JaiPipatt/Capstone-Project/progress_reports/progress_report_1/progress_report.pdf

# Capstone Project Progress Report

### October 18, 2026

## 1 Project Timeline

- Completed:
- In progress:
- Next:

## 2 Project Phases

### 2.1 Phase A

### 2.2 Phase B

### 2.3 Phase C

### 2.4 Phase D

## 3 Module CAD Design


Figure 1: Exploded view of the module CAD design.


Figure 2: Front view of the module CAD design.


Figure 3: Rear view of the module CAD design.


Figure 4: Top view of the module CAD design.


Figure 5: Tilted sectional view of the module CAD design.

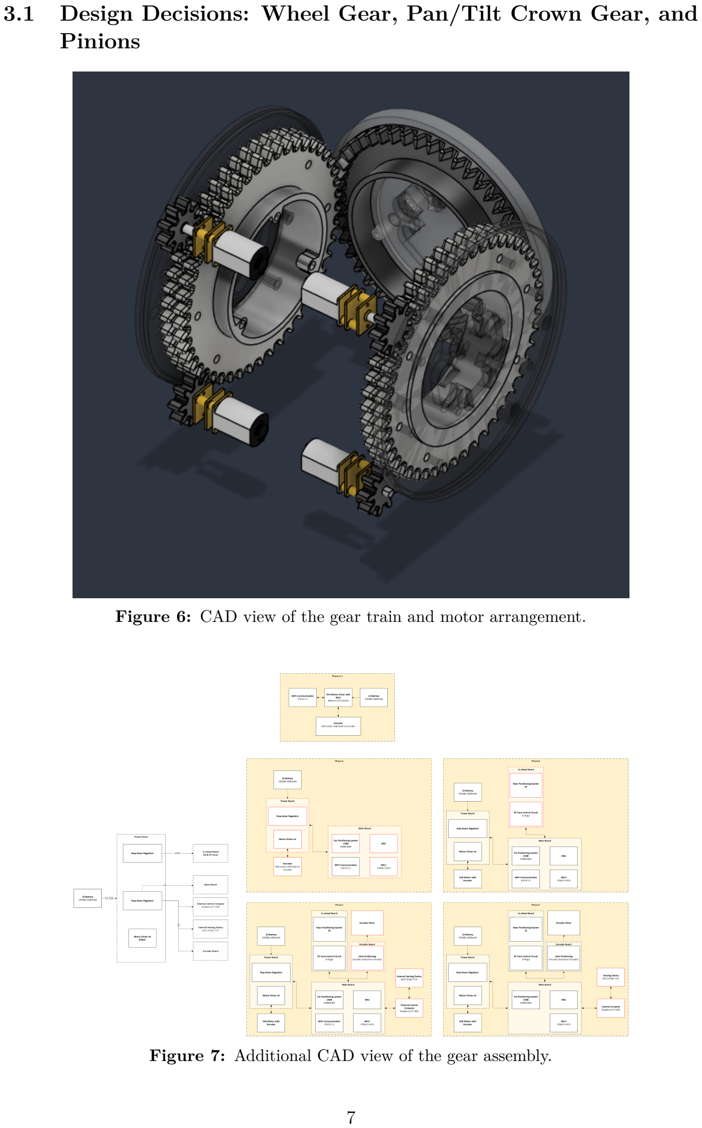
[picture p21: page 7]

### 3.1 Design Decisions: Wheel Gear, Pan/Tilt Crown Gear, and Pinions

Figure 6: CAD view of the gear train and motor arrangement.

Figure 7: Additional CAD view of the gear assembly.

### 3.1.1 Starting Point: Reverse-Engineering the SMORES-EP Reference

SMORES-EP is not open-source, so no CAD or drawing set was available. The gear train therefore had to be reconstructed from published dimensions and photographs and then re-derived from first principles.

The known reference parameters are listed in Table 1.

Table 1: Reconstructed SMORES-EP reference parameters.

Parameter | SMORES-EP

Module envelope 80 × 80 × 80 mm

Spur gear | 48 teeth
Crown gear | Same part as the spur gear, used at 90◦
Pinion | 9 teeth
Gearbox | 298:1

Assuming the 80 mm cube is the full envelope (wheels included), the largest gear that can physically fit is approximately 70 mm in outside diameter. Using the outside-diameter relation
Do = m(z + 2), | (1)

m =

70
48 + 2
= 1.4. | (2)

This gives a consistent, self-checking picture of the original: module 1.4, pitch diameter 67.2 mm, and a stage ratio of 48/9 = 5.33. This reconstructed module is the baseline against which all scaling decisions below are made.

### 3.1.2 Envelope Change and Its Consequences

The new module is 100 × 100 × 100 mm rather than 80 mm. This was driven by internal packaging (motors, gearboxes, electronics, and the pan/tilt joint) rather than by the gears themselves, but it directly sets the available gear space.

Allowing for wall thickness, bearing seats, and clearance to the housing, the largest practical spur gear outside diameter is 90 mm. Everything downstream follows from that number.

### 3.1.3 Wheel Spur Gear and Pinion

Tooth counts — why the ratio was held constant. The decision made first, before any dimension was fixed, was to preserve the original 5.33:1 stage ratio:

- Spur gear: 64 teeth
- Pinion: 12 teeth
- Ratio: 64/12 = 5.33 — identical to 48/9

The ratio was prioritised over any other parameter for three reasons:

1. The gearbox selection stays valid. The 298:1 gearbox reduction combines with the external stage to give the same total reduction as the reference design. Output speed and stall torque at the wheel therefore remain comparable, so motor and gearbox sizing carried over from SMORES-EP remains a defensible starting point instead of an unverified guess.
2. Published SMORES-EP performance data remains a usable benchmark. Locomotion speed, climbing ability, and joint torque figures reported for the original can be treated as an approximate expectation for this design. If the ratio had been changed, every performance claim would have had to be re-derived from scratch with no reference to check against.
3. Control and firmware behaviour is preserved. Encoder counts per wheel revolution, velocity limits, and any feed-forward torque terms scale with the total reduction. Holding it constant removes a whole class of retuning work.

Why 64/12 rather than 48/9 scaled directly. Multiple tooth-count pairs give 5.33:1. The pair 64/12 was chosen because increasing the pinion from 9 to 12 teeth materially improves the pinion, which is always the weakest and most heavily loaded element in the stage:

- Reduced undercutting. At a 20◦ pressure angle the theoretical minimum tooth count before undercut is zmin = 2/ sin² 20◦ ≈ 17. A 9-tooth pinion is far below this and suffers severe undercut at the tooth root, removing material exactly where bending stress is highest. A 12-tooth pinion is still below the theoretical limit, but the root section is considerably healthier.
- Higher contact ratio. More teeth on the pinion increases the length of the line of action relative to the base pitch, so more teeth share the load at any instant. This reduces peak tooth stress and smooths torque transmission.
- Better load sharing per cycle. A 12-tooth pinion completes fewer revolutions per gear revolution than a 9-tooth pinion, so each pinion tooth accumulates fewer loading cycles over the robot’s life — a direct fatigue-life benefit for the most stressed part.
- Larger pinion bore. A 12-tooth pinion at this module has enough body to carry the motor shaft bore and the wall thickness around it without the bore breaking into the tooth roots.

Undercut outcome at 12 teeth. Because 12 teeth sits below the 17-tooth theoretical threshold, some root undercut is expected in the generated profile. On inspection of the generated geometry and on assembling the mesh in CAD, the undercut present at 12 teeth does not cause interference: the mating spur gear tooth tips clear the undercut region throughout the mesh cycle at the design centre distance, and no tip-to-root fouling is observed. The undercut is therefore accepted as a minor reduction in root section rather than treated as a defect requiring correction, and no profile shift was applied. This keeps the pinion a standard, directly generated part.

Resulting geometry. With 64 teeth at a 90 mm outside diameter,

m =

90
64 + 2
= 1.3636 ≈ 1.36. | (3)

The resulting geometry is summarised in Table 2.

Table 2: Wheel spur gear and pinion geometry.

Parameter | Value
Module, m | 1.36
Pressure angle | 20◦ (standard)
Spur gear teeth | 64
Spur pitch diameter | 87.04 mm
Spur outside diameter | 90 mm
Pinion teeth | 12
Pinion pitch diameter | 16.32 mm
Pinion outside diameter | 19.04 mm

Theoretical centre distance 51.68 mm

Face width | 5 mm
Backlash | 0.2 mm
Root fillet | 0.3 mm

A 20◦ pressure angle was used throughout. It is the industry standard, it gives thicker tooth roots and better load capacity than 14.5

◦
| , it tolerates small centre-distance er-
rors well (important for a printed or lightly-toleranced housing), and it is the default assumption of every standard gear generator and cutting tool, which keeps the design manufacturable by more than one process.

The gears were generated using the Fusion 360 spur gear extension, entering pressure angle, module, tooth count, backlash, root fillet, and face width directly. Using a parametric generator rather than hand-sketched profiles guarantees a true involute flank and makes it cheap to regenerate the part when an upstream parameter changes — which, as the following subsection shows, happened repeatedly.

The 0.2 mm backlash and 0.3 mm root fillet are deliberate manufacturing allowances rather than theoretical values. Backlash absorbs centre-distance error, shaft deflection, bearing play, and thermal expansion, preventing tooth binding; the root fillet reduces the stress concentration at the tooth root, which is the standard bending-failure location.

### 3.1.4 Pan/Tilt Crown Gear

Departure from the SMORES-EP approach. SMORES-EP used a single gear part in two roles: as a conventional spur gear, and as a de facto crown gear meshing at 90◦
. This is convenient for manufacturing — one part number, one tool — but it is a compromise. A spur profile engaged at 90◦ does not have conjugate contact with its mate; contact degenerates toward a point or a short line near the tooth tip, which concentrates stress, increases wear, and produces a mesh that is sensitive to axial position.

This design instead uses a true crown (face) gear, with teeth formed on the face of the disc and oriented vertically so that they mesh with the mating spur gear. This gives line contact across the tooth face and a substantially better load distribution for the same envelope.

Iteration history. The crown gear was the most constrained part in the assembly, because its diameter had to coexist with the motors, the gearboxes, the two wheel gear trains, and the structural frame — all inside the 100 mm cube. The iterations are given in Table 3.

Table 3: Crown gear sizing iterations.

Iteration Diameter Teeth / Module Outcome

1 | 90 mm | 48 / 1.8 | Interference with surround- ing assembly — rejected
Final | 84 mm | 46 / 1.75 | Fits with clearance

The first attempt simply mirrored the spur gear’s 90 mm diameter. On assembly it fouled adjacent components, so the diameter had to be reduced. The final geometry is consistent with the same outside-diameter relation:

Do = 1.75 × (46 + 2) = 84 mm. | (4)

Module mismatch: an accepted, envelope-driven compromise. Standard gear practice requires that two meshing gears share the same module and the same pressure angle, since the module fixes the circular pitch and therefore whether the teeth index correctly against one another. That condition could not be satisfied here. Two constraints fixed the geometry before the module could be chosen freely:

1. Both diameters are fixed by packaging. The spur gear outside diameter is capped at 90 mm by the 100 mm envelope, and the crown gear outside diameter is capped at 84 mm by interference with the motors, gearboxes, and frame — as established in the iteration above. Neither diameter is a free variable.
2. The tooth counts are fixed by the ratios being preserved. The spur gear must have 64 teeth to hold the 5.33:1 wheel stage ratio, and the crown gear must stay near 46–48 teeth to hold the near-1:1 spur-to-crown relationship of the original design.

With both Do and z fixed on each part, m = Do/(z + 2) is fully determined, and the two values simply are not equal: 1.36 for the spur gear against 1.75 for the crown gear. Forcing a common module would have required either abandoning the preserved gear ratios — discarding the benchmark value of the SMORES-EP reference data and the validity of the motor and gearbox selection — or enlarging a gear beyond the envelope it has to fit in.

The design therefore treats matched modules as the parameter to sacrifice, because it is the one whose relaxation is recoverable at assembly (through tooth-depth and backlash adjustment) rather than structural. Concretely, the crown tooth depth was tuned during iteration to obtain a working mesh at the assembled centre distance, and the dedendum modification described below is part of that adjustment. This is a documented deviation from standard practice rather than an oversight, and it is one of the primary items to be validated once physical parts exist.

Why tooth count was held near 1:1 with the spur gear. The original design has an effective 1:1 tooth-count relationship between spur and crown (48 and 48). Rather than abandoning this when the diameter had to shrink, the design keeps the counts as close as the envelope permits: 46 teeth against the original’s 48, a 4 % deviation.

Keeping the tooth counts nearly equal, and therefore the tooth size nearly equal, matters for several reasons:

- The pan/tilt joint ratio stays near unity. With a near-1:1 mesh, output speed and torque at the joint are close to what the driving stage delivers. The joint’s angular velocity and holding torque are therefore predictable from the motor and gearbox specification without an extra reduction factor to characterise, and the SMORES-EP joint performance data stays usable as a benchmark.
- Tooth size — not just ratio — sets load capacity. Tooth bending strength scales roughly with the square of the module for a given face width and material (Lewis bending equation). A 46-tooth crown at m = 1.75 has larger teeth than the 64-tooth spur at m = 1.36, so the crown teeth are individually stronger. This is desirable: the crown gear carries the full pan/tilt reaction load, including any static holding torque when the joint is supporting the robot’s own weight or resisting an external load, and it is the harder part to replace.
- Mesh symmetry between the two driving gears. Because two identical spur gears drive the single crown from opposite sides, keeping the crown’s tooth size and count close to symmetric ensures both meshes see comparable loading and wear, rather than one side dominating.
- No hidden speed asymmetry between pan and tilt. Pan and tilt are produced by the same two inputs in common mode or differential mode. A near-1:1 crown keeps the effective ratio for both modes similar, so the two motions have comparable speed and torque characteristics and can share a single control tuning.

Dedendum modification. Standard practice sets the dedendum to 1.25 m, which for m = 1.75 gives 2.1875 mm. The design uses a slightly reduced 2.15 mm.

This small reduction (0.0375 mm, about 1.7 %) trims the root depth just enough to clear the mating tooth tip within the assembled centre distance without carving further into the root section. Because tooth bending strength is governed by the root thickness, a shallower dedendum marginally increases the root section and therefore does not weaken the tooth — the trade-off is a small reduction in tip clearance, which is acceptable given the 0.2 mm backlash already designed in. It is a compromise between manufacturing feasibility and the clearance required to avoid tip-to-root interference.

### 3.1.5 Pinion Mounting and Tolerances

The two pinion variants differ only in how they attach to the motor shaft, which is dictated by their position in the assembly (Table 4).

A 0.1 mm tolerance is applied to the shaft bores. This is a clearance/transition allowance covering manufacturing variation in both the printed or machined bore and the shaft

Table 4: Pinion bore variants.

Pinion | Bore | Rationale

Pan/tilt Through-hole The motor shaft passes fully
| | through the pinion, allowing the shaft to be supported on both sides and the pinion to sit at an arbi- trary axial position along it
Wheel | Blind hole | Fitted onto the end of the shaft; the closed face provides a positive axial stop and a sealed, stiffer end

diameter. Too tight and the pinion cracks or cannot be assembled; too loose and backlash appears at the shaft interface, degrading positional accuracy and introducing shock loading on direction reversal.

The gears and plain-bearing surfaces will be printed in nylon. Nylon was selected because it provides good strength for the expected mechanical loads while also offering relatively low friction and wear, which is useful for the plain-bearing interfaces in the module. The final shaft-to-bore fit is not yet treated as fixed: a test shaft and bore will be printed first, measured, and assembled to determine whether the nominal 0.1 mm allowance provides the required balance between free movement and acceptable backlash. The bore dimension will be adjusted if the first test shows that the printed nylon shrinks, distorts, or grips the shaft more than expected.

The spur gear carries a bolt-hole pattern on its web for attachment to the wheel hub and to adjacent structural parts. Placing the holes in the web rather than near the rim keeps them clear of the tooth root region, where bending stress is highest.

### 3.1.6 Drivetrain Architecture

The module uses four motors driving four spur gears:

- Outer two spur gears — one per side, each driving a wheel directly. These provide differential-drive locomotion.
- Inner two spur gears — both mesh with the single crown gear that carries the two side-mounted spur gears.

The pan/tilt degrees of freedom are produced differentially from these two inner inputs:

- Inner gears rotating in the same direction (common mode) → pan
- Inner gears rotating in opposite directions (differential mode) → tilt

This differential arrangement is the main structural reason the crown gear geometry matters so much. Both inner spur gears must mesh with the same crown gear simultaneously and symmetrically; any asymmetry in the two meshes appears as a coupling error between the pan and tilt axes, not merely as local wear. It also explains why crown gear diameter was the binding constraint during iteration — it must remain concentric with the joint axis while two separate drive trains and two wheel trains are packed around it.

### 3.1.7 Summary of Final Parameters

Table 5: Final gear train parameters.

Component | Teeth Module Outside dia. Notes
Wheel/drive spur gear 64 | 1.36 | 90 mm | 5 mm | face | width,
mounting holes in web
Pinion (both types) | 12 | 1.36 | 19.04 mm | Through-bore
(pan/tilt) or | blind
bore (wheel)
Crown gear | 46 | 1.75 | 84 mm | Dedendum 2.15 mm;
true face-gear teeth

Common to all: 20◦ pressure angle, 0.2 mm backlash, 0.3 mm root fillet, 0.1 mm bore tolerance.

### 3.1.8 Current Status and Remaining Work

All of the geometry above exists as a CAD model only. No part of the gear train has been 3D printed, manufactured, or tested in the real world at the time of writing. Every clearance, interference, and mesh result reported in this section was obtained from the CAD assembly, not from physical hardware, and should be read as a design intent rather than a verified outcome.

The following items are therefore outstanding and are the priority for the next phase:

- Print a first article of the spur gear, both pinions, and the crown gear, and verify that the spur/crown mesh functions despite the module mismatch discussed above.
- Confirm that the 12-tooth pinion’s undercut remains non-interfering at real printed tolerances, where layer resolution and shrinkage are additional error sources not captured in CAD.
- Check that the 0.2 mm backlash and 0.1 mm bore tolerance are appropriate for the chosen printing process and material; adjust and reprint if the fit is tight or loose.
- Measure the achieved pan and tilt ranges and the joint holding torque against the SMORES-EP benchmark figures used to justify the ratio decisions.
- Run an endurance check on the crown gear teeth, which carry the highest sustained load in the assembly.

The outer mechanical design is based on the SMORES-EP modular robot developed by the ModLab at the University of Pennsylvania [?]. The original SMORES-EP module is approximately 80 mm in size. For our prototype, the main dimensions were adapted to 100 mm to provide more space for the required mechanical and electronic components.

### 3.2 Outer Wheels

Two independently driven outer wheels were designed based on the differential-drive arrangement of SMORES-EP. Each wheel has a diameter of 100 mm and includes a groove for an NBR N70 O-ring with a cross-section of approximately 1.5 mm, which is used as the rubber tire. Space for the EP-magnet docking mechanism is also provided in the wheel. Mounting posts were added to provide a mounting location for the PCB that will generate the electrical pulse for switching the EP-magnet coil.


Figure 8: Interior view of the wheel and drivetrain assembly.


Figure 9: Exterior view of the wheel and module assembly.

### 3.3 Pan Face

The pan face was designed based on the SMORES-EP pan mechanism. It has a diameter of 90 mm and does not include the O-ring groove used on the driving wheels. Space for the EP-magnet docking mechanism is included in the face.

### 3.4 Tilt Face

The tilt face was adapted from the SMORES-EP tilt mechanism. The outer rectangular part has dimensions of approximately 90×71.6 mm and includes space for the EP-magnet docking mechanism. An additional motor mount was added to accommodate the motor used in our prototype.

## 4 Electronics: Project Plan and Current State

### 4.1 Electronics work plan

The electronics work follows the four project phases, split into A-1, A, B, C and D. Each phase’s block diagram shows the subsystems built in that phase; dashed boxes mark the module or PDB that holds them.

Phase A-1 uses COTS parts for early locomotion and mechanism testing: a 2S battery, a 4-channel motor driver with built-in MCU, and an ESP32-C3 for Wi-Fi (Figure 10).

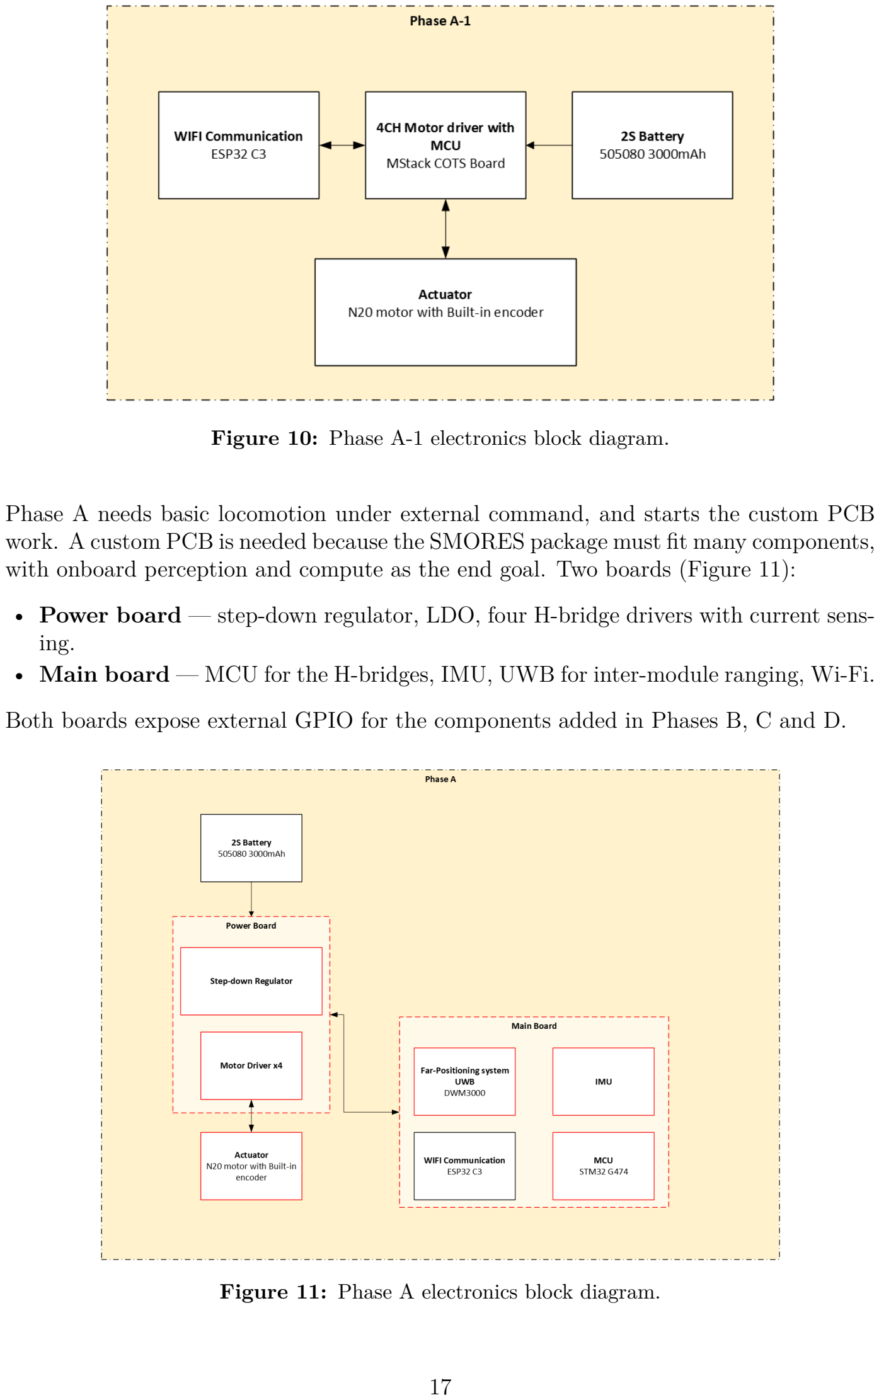
[picture p22: page 17]

Figure 10: Phase A-1 electronics block diagram.

Phase A needs basic locomotion under external command, and starts the custom PCB work. A custom PCB is needed because the SMORES package must fit many components, with onboard perception and compute as the end goal. Two boards (Figure 11):

- Power board — step-down regulator, LDO, four H-bridge drivers with current sensing.
- Main board — MCU for the H-bridges, IMU, UWB for inter-module ranging, Wi-Fi.

Both boards expose external GPIO for the components added in Phases B, C and D.

Figure 11: Phase A electronics block diagram.

Phase B needs module-to-module connection. The work is an in-wheel PCB with the EP-Face circuitry and the IR contact-alignment circuit. It is powered from the power board and talks to the main board through a slip ring, covered in the electrical connection section (Figure 12).


Figure 12: Phase B electronics block diagram.

Phase C adds onboard perception: an RGB-D/ToF camera, with the compute unit still wired externally. It also adds a wheel encoder, because the motor’s built-in encoder sits before several gear stages and cannot sense wheel angle precisely (Figure 13).

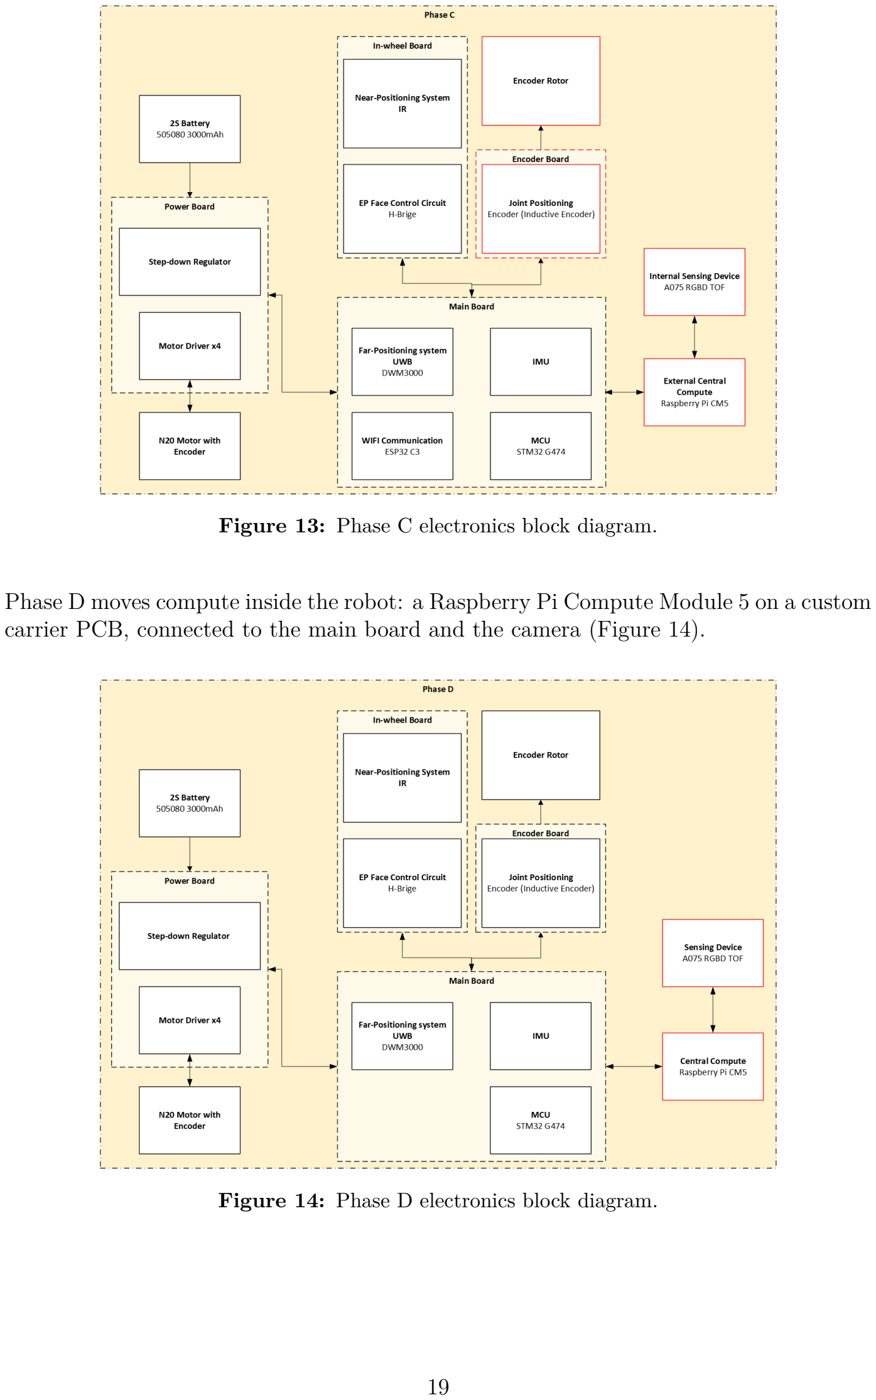
[picture p23: page 19]

Figure 13: Phase C electronics block diagram.

Phase D moves compute inside the robot: a Raspberry Pi Compute Module 5 on a custom carrier PCB, connected to the main board and the camera (Figure 14).

Figure 14: Phase D electronics block diagram.

### 4.2 Electronics component selection

Table 6 lists the selected components, their subsystem and the specifications behind the choice. Values are from datasheets; the EP-Face and IR board is custom and its figures come from the Phase B build.

Table 6: Selected electronics components by subsystem.

Component Subsystem and
phase
Key specifications | Interface and
supply

4 × N20
gearmotor
with encoder

Joint drive for the
four DoF (left,
right, pan, tilt);
Phase A-1 onward

6 V, 50 rpm; magnetic
quadrature encoder, 7 PPR, on the motor shaft

A/B quadrature
to the MCU;
driven by
H-bridge

STM32G474 Main-board MCU:
joint control, sensor
sampling, data link;
Phase A onward

Cortex-M4F at 170 MHz;
timer-triggered 12-bit ADCs; three FDCAN

SPI, I2C,
UART, CAN;
1.71–3.6 V

ICM-42688-P 6-axis IMU for attitude and
orientation; Phase
A onward

Gyro ±2000 dps, accel ±16 g; ODR to 32 kHz

SPI or I2C;
1.71–3.6 V

Qorvo
(Decawave)
DW3000

UWB transceiver
for inter-module
ranging and coarse
relative
localisation; Phase
A onward

IEEE 802.15.4z; channels 5 and 9; ranging accuracy of order 10 cm

SPI; 2.4–3.6 V

ESP32-C3 | Wi-Fi link; standalone controller in Phase A-1, wireless co-processor from Phase A
RISC-V at 160 MHz; Wi-Fi 4 and Bluetooth 5 LE

UART or SPI to
the main MCU;
3.0–3.6 V

EP-Face and
IR board

In-wheel docking
face:
electropermanent
magnet connector
and IR
contact-alignment
sensing; Phase B

Custom PCB; EP magnet
pulse-switched, holds with no power; IR emitter/receiver pairs. Figures set by the Phase B design

Powered from
the power board;
data via slip ring

Raspberry Pi
Compute
Module 5

Onboard compute
for perception and
planning; Phase D

Quad-core Cortex-A76 at
2.4 GHz; 2–16 GB RAM; PCIe and MIPI CSI

Custom carrier
board; 5 V

Sipeed
MaixSense
A075V

RGB-D/ToF
camera for onboard
perception; Phase
C onward

ToF depth 320 × 240 at 30 fps, range 0.2–2 m; RGB 800 × 600

USB 2.0 or
UART; 5 V

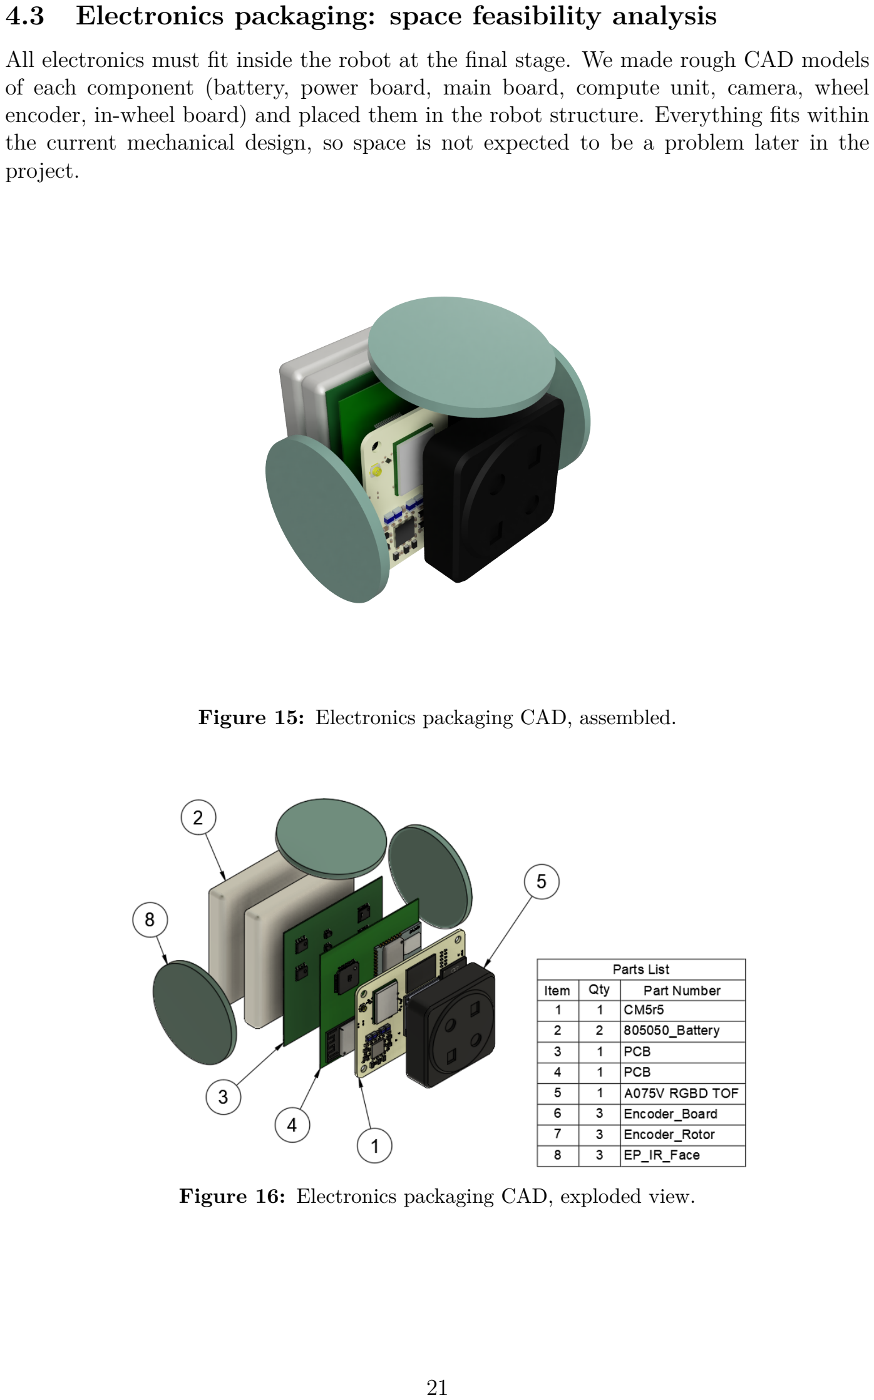
[picture p24: page 21]

### 4.3 Electronics packaging: space feasibility analysis

All electronics must fit inside the robot at the final stage. We made rough CAD models of each component (battery, power board, main board, compute unit, camera, wheel encoder, in-wheel board) and placed them in the robot structure. Everything fits within the current mechanical design, so space is not expected to be a problem later in the project.

Figure 15: Electronics packaging CAD, assembled.

Figure 16: Electronics packaging CAD, exploded view.

### 4.4 Additional scope not covered in the proposal: wheel encoder

The original SMORES sensed joint angle with a continuous-rotation potentiometer geared to the joint shaft. The wiper voltage gives the shaft angle directly, so position is absolute at power-up with no homing. The cost is coarse resolution (about 5◦
), contact wear, and
backlash from the gear stage. The project is replacing this with a non-contact encoder.

Three options were considered; Table 7 compares them.

Table 7: Wheel-rotation sensing options compared.

Criterion | On-axis magnetic rotary encoder (e.g. AS5600, AS5048) | Off-axis magnetic tape encoder (1 mm pole pitch)
Custom inductive
encoder (PCB coil
and
inductance-to-digital
IC)
Sensing principle | Diametrically magnetised magnet on the shaft end, read by a Hall-effect IC; angle from atan2(sin, cos) | Magnetised tape ring bonded to the wheel rim, read off-axis by a magnetoresistive or Hall read head at a fixed radial gap

PCB transmit and
receive coils excite eddy
currents in a conductive
rotor target; phase and
amplitude of the return
signal encode angle
Output | Absolute over one turn | Incremental; an index or reference mark is needed to recover absolute position

Absolute over one turn,
depending on coil layout
Resolution | 12–14 bit; below 0.1◦
| with interpolation

Set by pole pitch and
interpolation; medium
to high

Set by coil geometry;
comparable to magnetic
encoders with
interpolation
Mounting | Requires a free shaft end centred on the sensor IC

Anywhere on the rim;
the shaft end stays free

Flat PCB facing the
rotor target with a
controlled
sub-millimetre air gap
Immunity to magnetic fields | Sensitive to stray fields from the motors and the EP connector; needs shielding or standoff distance
Same exposure as
on-axis, plus sensitivity
to tape bonding and
alignment error

Immune; unaffected by
the motors or the EP
connector

Design effort
and cost

Low; off-the-shelf IC
with mature firmware

Medium; tape must be
applied and aligned
precisely, and a
dedicated read-head IC
is needed

High; custom coil
design, rotor target
machining and
calibration, with no
drop-in part

Fit for this
project

Simplest and lowest
risk, but the SMORES
layout already uses the
wheel shaft end for
gearing and mounting,
so a clear axial spot
must be reserved

Frees the shaft end, but
adds a homing step at
power-up and a wear
and bonding risk on the
tape

Best fit to the EP
connector’s nearby field,
but the highest design
time and schedule risk
within the capstone
timeline

The EP connector’s field is close to the wheel sensor, so the two magnetic options carry an interference risk the inductive option does not. Weighing that against the extra design effort is the open decision for Phase C.

### 4.5 Current focus: robot locomotion

### 4.5.1 Power system

The budget is built in three steps: the current each component draws (Table 8), the average load over a mission once duty cycles are applied (Table 9), and the power drawn from the pack after regulator losses, which gives the run time (Table 10).

Component loads. Table 8 gives the rail, typical current and maximum current for each component. Typical is normal duty; maximum is the worst case the power IC must survive. Rows marked * are estimates to be measured in Phase A-1.

Table 8: Component current by rail.

Component | Rail | Typical current

Maximum
current

Condition

4 × N20
gearmotor (6 V,
50 rpm)

Pack,
PWMlimited to
6 V

0.07 A each;
0.28 A for
four

1.0 A each;
4.0 A for
four

Typical is no-load;
maximum is all four stalled, at 6 V equivalent
STM32G474 | 3.3 V | 30 mA | 60 mA | 170 MHz; maximum with all peripherals active
ICM-42688-P | 1.8 V (3.3 V
I/O)
| | 0.9 mA | 1.2 mA | Six-axis low-noise mode
DW3000* | 3.3 V | 45 mA | 50 mA | Listening; transmit peak. Idle about 10 mA, deep sleep below 1 µA
ESP32-C3 | 3.3 V | 90 mA | 335 mA | Wi-Fi active; maximum is 802.11b transmit. Modem sleep 20 mA
EP-Face and IR board* | — | — | To be calculated from the EP design | Steady draw is IR only; the EP magnet holds with no current. The pulse comes from a local capacitor, so the rail only sees recharge current

Raspberry Pi Compute Module

5 * | 5 V | 1.2 A | 3.0 A | Idle about 0.6 A; maximum is full CPU load, no USB peripherals
Sipeed MaixSense A075V* | 5 V | 0.4 A | 0.5 A | ToF illuminator active at 30 fps

Mission average. Table 9 applies a duty cycle to each component over a representative mission: mostly driving, intermittent ranging, occasional docking, perception always on.

Table 9: Estimated average load over a representative mission.

Component | Rail | Active current
Duty cycle | Average
current at
rail

Average
power

2 × N20 wheel
motors

Pack,
PWM to
6 V

0.25 A each
(loaded, est.)

60 %
(driving)
0.30 A | 1.80W

2 × N20 pan and
tilt motors

Pack,
PWM to
6 V

0.25 A each
(loaded, est.)

15 % (reconfiguring)

0.075 A | 0.45W
STM32G474 | 3.3 V | 30 mA | 100 % | 30 mA | 0.10W
ICM-42688-P | 1.8 V | 0.9 mA | 100 % | 0.9 mA | <0.01W
DW3000 | 3.3 V | 45 mA listening; 10 mA idle | 25 % ranging, 75 % idle | 19 mA | 0.06W
ESP32-C3 | 3.3 V | 90 mA active; 20 mA modem sleep

60 % active,
40 % sleep
62 mA | 0.20W

EP-Face and IR
board
3.3 V | 35 mA | 20 % docking approach
7 mA | 0.02W

Raspberry Pi
Compute Module
5
5 V | 1.2 A | 100 % | 1.2 A | 6.00W

Sipeed MaixSense
A075V
5 V | 0.4 A | 80 % | 0.32 A | 1.60W

Total at the
rails

10.2W

Table 10: Power drawn from the pack by rail, including converter efficiency.

Rail | Load at rail | Conversion from pack | Power from pack
Motors (pack, PWM to 6 V) 2.25W | H-bridge, 95 % | 2.4W
5 V (compute, camera) | 7.60W | Buck, 90 % | 8.4W
3.3 V and 1.8 V (MCU, sensors, radios) | 0.38W | LDO from 5 V, 66 %, then buck, 90 % | 0.65W
Total from pack | 11.5W

Battery run time. The pack is two 505080 cells in series, 3000 mAh, 22.2Wh, of which 17.8Wh is usable to cutoff. 11.5W from the pack is 1.55 A at 7.4 V, about 0.5 C. Run time is about 1.5 h for the full Phase D module; the Phase A and B configuration, without compute and camera (73 % of the draw), runs about 5.8 h.

### 4.5.2 Power board components


Figure 17: Power distribution block diagram.

Power splits into three paths from the 2S pack:

- Motors. The four N20s run from the pack through the H-bridges. PWM duty is capped at about 70 % (6 V over 8.4 V at full charge) to hold the motors at their 6 V rating, and the H-bridge current sensing trips on stall. The on-time current at stall scales to about 1.4 A, so the H-bridges are rated for the pack voltage and 1.5 A per channel.
- EP-Face and IR. A dedicated step-down regulator feeds the in-wheel board and its pulse capacitor. The pulse itself comes from the capacitor; the separate regulator keeps the recharge current and pulse transients off the logic rail so the MCU and compute unit do not brown out during docking.
- Logic and compute. A second step-down regulator provides 5 V to the main board, encoder circuit, compute unit and camera; 3.3 V for the MCU, sensors and radios comes from an LDO on the main board. This rail carries about 1.6 A typical and 4 A peak (Table 8), so the regulator is rated 5 V / 5 A, which also meets the Compute Module 5 supply requirement.

Table 11: Maximum load per rail.

Rail | Loads | Maximum current | Maximum power
Motor drive (pack, PWM to 6 V) | 4 × N20 | 4.0 A at 6 V equivalent; 1.4 A per channel on-time at 8.4 V | 24W

5 V logic and
compute

CM5 3.0 A, camera 0.5 A,
3.3 V LDO input 0.45 A
4.0 A | 20W
3.3 V (from 5 V) | STM32 60 mA, IMU 1 mA,
DW3000 50 mA, ESP32-C3
335 mA

0.45 A (ESP32 transmit
burst)

1.5W

EP-Face and IR | IR 50 mA, pulse capacitor recharge

0.05 A steady +
recharge, TBD

TBD

Pack total | all rails at peak | ≈6.5 A at 7.4 V, ≈7.3 A at 6.6 V

≈47W

## 5 Preparation for Phase B: Magnet

The magnetic docking system is based on the Electro-Permanent Magnet EPM connector developed for SMORES-EP [?]. The original SMORES-EP module has a characteristic length of approximately 80 mm, and its EP-Face uses four EP magnets arranged in a ring on the connecting face. Each EP magnet consists of an AlNiCo 5 cylindrical magnet and an NdFeB magnet placed side by side, two low-carbon steel pole pieces, and a copper coil wound around the magnetic assembly. The original EP-Face uses magnet cylinders 4.76 mm in diameter and 9.53 mm in length, with the four-magnet arrangement fitting within a 42 mm diameter circular region. The magnets protrude approximately 0.5 mm from the connecting face. The copper coil uses 30 AWG wire with 200 turns [?]. For our 100 mm prototype, this arrangement and its associated dimensions serve as the design reference and are being adapted to fit our larger face and mechanical structure.


Figure 18: Interior view of the rectangular magnet housing.

The operating principle relies on the contrasting magnetic properties of AlNiCo 5 and NdFeB. AlNiCo 5 has relatively low coercivity, meaning its magnetization direction can be reversed by an external magnetic field. NdFeB, in contrast, has high coercivity and retains its magnetization under the same field pulse. This difference allows the two magnets to work together as a switchable permanent-magnet system.

A short electrical pulse is sent through the copper coil, generating a magnetic field around the magnet assembly. This pulse reverses the magnetization direction of the AlNiCo 5 while the NdFeB remains magnetized in its original direction. When the two magnetic fields are aligned, they reinforce each other and the resulting magnetic flux is guided through the steel pole pieces toward the connecting face. This produces the ON state, generating an attractive force with a mating EP connector.

When a pulse is applied in the opposite direction, the AlNiCo 5 magnetization reverses while the NdFeB remains unchanged. The two magnetic fields then oppose each other, reducing the magnetic flux reaching the connecting face. This produces the OFF state, allowing the modules to separate. Since the magnetic state remains after the pulse, continuous power is not required to maintain the ON or OFF state.

The original EP-Face uses AlNiCo 5, NdFeB, ASTM 1018 low-carbon steel pole pieces, and a copper coil with 30 AWG wire and 200 turns. For our prototype, the selected materials are:

- AlNiCo 5 rod magnet
- NdFeB magnet
- Mild steel 1018 / S20C
- 30 AWG enamelled copper wire

The EP-magnet dimensions, coil winding parameters, and driving circuit will be finalized through fabrication and testing in Phase B.

## 6 Shaft Tolerance Analysis: Plain Bearing (∅55 mm)

The plain bearing (OD = 55 mm, ID = 50 mm) acts as the shaft. Every printed nylon component has a bore that fits around the bearing outer diameter. Four joints use this interface, classified in Table 12.

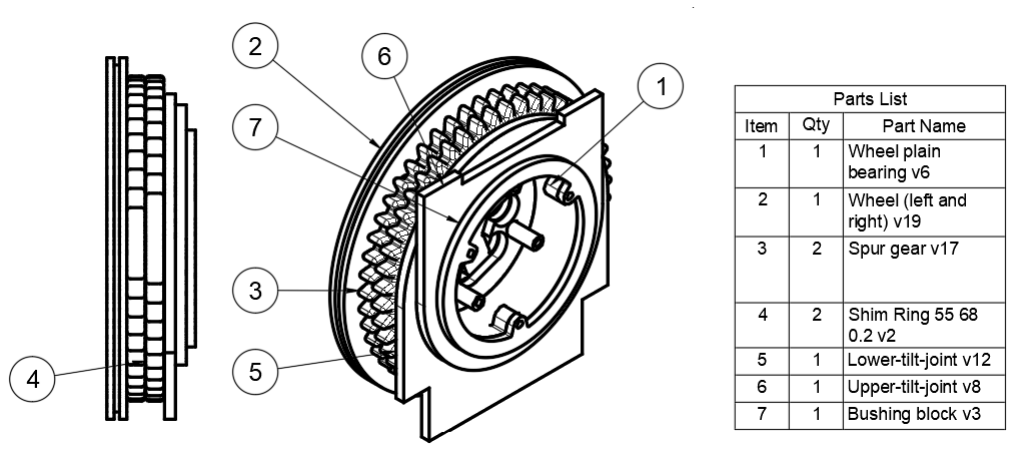
[picture p25: figure]

Figure 19: Shaft and bearing component arrangement.

Table 12: Joint classification for the ∅55 mm bearing interface.

Joint Component | Motion | Fit | ISO Class
J1 | Wheel + 1st Spur Gear | Dynamic Clearance | F7/h6
J2 | 2nd Spur Gear (Pan/Tilt) Dynamic Clearance | F7/h6
J3 | Upper Tilt Joint | Dynamic Clearance | F7/h6
J4 | Lower Tilt Joint | Static | Interference P7/h6

### 6.1 ISO 286 Tolerance Results

For ∅55 mm (size range 50 < d ≤ 80 mm), the tolerance unit is i = 1.856 µm, giving IT6 = 19 µm and IT7 = 30 µm. The bearing OD is modelled as h6 (55.000–54.981 mm). Table 13 summarises the theoretical fit limits.

Table 13: ISO 286 theoretical fit limits.

Type | Bore Class Dmin (mm) Dmax (mm) Fit Min (mm) Fit Max (mm)
Dynamic F7 | 55.030 | 55.060 | +0.030 CL | +0.079 CL
Static | P7 | 54.938 | 54.968 | +0.013 IF | +0.062 IF

### 6.2 3D-Printing Compensation

FDM-printed holes in nylon are systematically undersized (≈ −0.10 to −0.30 mm diametrally) due to inward filament flow, thermal contraction (1–2 %), and surface roughness. The CAD bore is therefore oversized to compensate: DCAD = Dtarget + |∆hole|. Dynamic bores receive +0.20 mm compensation; static bores receive +0.10 mm (smaller, because shrinkage helps create the desired interference).

### 6.3 Recommended Bore Sizes

Table 14 gives the recommended starting CAD bore for each part. These values will be validated through the print-and-test procedure described below.

Table 14: Recommended CAD bore sizes for ∅55 mm bearing.

Part | Joint | CAD Bore (mm) Expected Fit
Wheel (Item 2) | J1 Dynamic | ∅55.30 | ≈ 0.10–0.20 CL

1

st Spur Gear (Item 3) | J1 Dynamic | ∅55.30 | ≈ 0.10–0.20 CL

2

nd Spur Gear (Item 3) | J2 Dynamic | ∅55.30 | ≈ 0.10–0.20 CL
Upper Tilt Joint (Item 6) J3 Dynamic | ∅55.30 | ≈ 0.10–0.20 CL
Lower Tilt Joint (Item 5) J4 Static | ∅54.90 | ≈ 0.05–0.15 IF
CL = Clearance | IF = Interference | Bearing OD = ∅55.00 mm

### 6.4 Print-and-Test Procedure

Test rings (OD = 70 mm, height = 10 mm) will be printed in nylon at five CAD bore sizes for each fit type:

- Dynamic (J1–J3): ∅55.10, 55.20, 55.30 (recommended), 55.40, 55.50 mm. Pass criterion: bearing slides in by hand, part spins freely, radial play ≤ 0.20 mm.
- Static (J4): ∅54.70, 54.80, 54.90 (recommended), 55.00, 55.10 mm. Pass criterion: bearing requires firm hand pressure or light mallet tap to insert, no rotation under hand torque, no cracking.

Parts are cooled to room temperature (23(2) ◦C) for ≥ 2 hours before measurement. Each bore is measured with a digital caliper at three angles (0

| | ◦ , 60◦

, 120◦
| | | ) and averaged. The
printer offset is ∆ = Dmeasured − DCAD (typically −0.10 to −0.30 mm). The smallest dynamic bore that spins freely and the largest static bore that prevents rotation are selected for production prints.

## 7 Software Testing Plan for Phase A

This section describes the testing plan for evaluating the software system during Phase
A. The objective is to verify that the software system can reliably detect and identify the robot ID from AprilTags using an external camera and image processing techniques. The detected information will be used to correct the robot’s position and orientation in real time, enabling effective navigation within the environment. In addition, the software system will control the robot’s actuators and sensors to ensure that the robot performs its intended functions accurately and efficiently using PID control. The system will also be tested for its ability to plan and execute paths for the MSRR configuration of the robot.

### 7.1 Testing Objectives

The main objectives of the software testing are:

- Verify that the software system can accurately detect and identify the robot ID from AprilTags using an external camera and image processing techniques.
- Verify that the software system can use the detected AprilTag information to estimate and correct the robot’s position and orientation in real time.
- Verify that the software system can control the robot’s actuators and sensors accurately and efficiently using PID control.
- Verify that the software system can reliably plan and execute paths for the MSRR configuration of the robot.
- Evaluate the overall integration between perception, localization, control, and path planning components.

### 7.2 Testing Setup

The software will be tested using the MSRR robot in a controlled indoor environment. An external camera will be positioned to provide a view of the robot and the AprilTags placed within the testing area. The camera image will be processed by the perception system to detect the AprilTags and obtain the corresponding robot ID and pose information. The detected pose information will be transmitted to the robot control system and used to estimate the robot’s position and orientation. The robot will then use this information for localization, path planning, and motion control. The actuators will be controlled using PID controllers to achieve the desired wheel velocities and robot motion. The testing setup will include:

- MSRR robot equipped with the required actuators and onboard sensors.
- External camera for AprilTag detection and robot localization.
- AprilTags with unique IDs for identifying the robot and reference locations.
- Computing system for image processing, localization, path planning, and control.
- Controlled testing area with predefined waypoints and paths.

### 7.3 Goal Configurations

The software testing plan will evaluate the following robot configurations:

Table 15: Goal configurations for Phase A testing

Configuration

Snake

Car

DoubleDriver

L-shape

### 7.4 Testing Procedure

The testing procedure will be divided into several stages. First, the external camera will capture images of the testing environment and the perception system will detect the AprilTags. The detected tag ID and pose will then be compared with the known tag information to verify the accuracy of the detection and localization. Next, the estimated robot position and orientation will be provided to the control system. The robot will be commanded to move to predefined target positions and orientations. The difference between the desired and measured states will be used to evaluate the performance of the localization and PID controllers. Finally, predefined paths will be provided to the path planning system. The robot will be required to generate and execute the planned paths while maintaining the required position and orientation. The complete software pipeline will be tested to verify the interaction between perception, localization, path planning, and motion control.

### 7.5 Evaluation Metrics

The performance of the software system will be evaluated using the following metrics:

- AprilTag Detection Rate: The percentage of test frames in which the correct AprilTag is successfully detected and identified.
- Position Error: The difference between the robot’s estimated position and its known or reference position, measured in meters.
- Orientation Error: The difference between the estimated robot orientation and the reference orientation, measured in degrees.
- Position Tracking Error: The difference between the desired robot position and the actual robot position while following a planned path.
- Orientation Tracking Error: The difference between the desired and actual robot orientation during motion.
- Path Execution Error: The deviation of the robot from the planned path during navigation.
- Control Response: The ability of the PID controllers to reach and maintain the desired actuator commands with minimal overshoot and steady-state error.
- Processing Rate: The frequency at which the perception and control system can process sensor information and update the robot’s state and control commands.

### 7.6 Acceptance Criteria

The software system will be considered to satisfy the Phase A requirements if it can reliably detect the correct AprilTag ID, estimate the robot’s position and orientation with an acceptable error, and provide sufficiently frequent updates for real-time control. The robot must also be able to follow predefined paths while maintaining acceptable position and orientation errors. The PID controllers must allow the robot to reach the desired motion commands with stable behavior and without excessive oscillation. The complete software system must also operate continuously without critical failures during the testing period. Specific numerical thresholds for detection accuracy, localization error, tracking error, and processing rate will be defined based on the requirements of the MSRR system and the physical limitations of the robot.

### 7.7 Expected Results

The expected outcome of Phase A testing is a software system that can reliably integrate external-camera perception, AprilTag-based robot identification and localization, path planning, and PID-based motion control. The system is expected to provide sufficiently accurate and stable position and orientation estimates for real-time robot navigation. The robot is expected to successfully follow predefined paths and reach target positions while maintaining acceptable tracking errors. Successful completion of these tests will demonstrate that the software components are sufficiently integrated and reliable to support the subsequent development and testing phases of the MSRR system.
