JaiPipatt/Capstone-Project/progress_reports/progress_report_1/progress_report_short.pdf

## Capstone Design Project I

### Progress Report

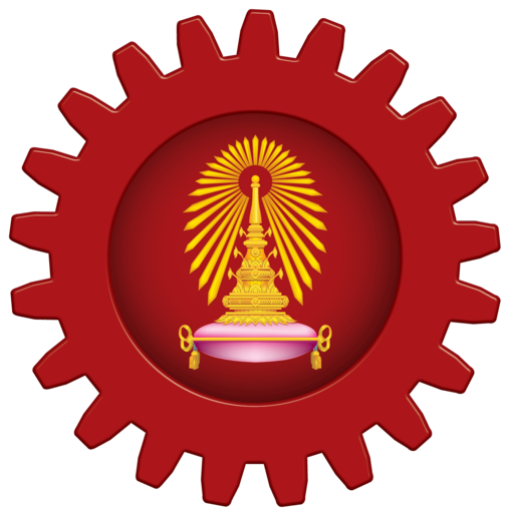
[picture p26: figure]

## A Modular Self-Reconfigurable Robot (MSRR)

## for Search and Space Exploration

Submitted to the

Project Committee appointed by the

International School of Engineering (ISE)

Faculty of Engineering, Chulalongkorn University

Project Advisors

Asst. Prof. Paulo Fernando Rocha Garcia, Ph.D.

Asst. Prof. Surat Kwanmuang, Ph.D.

Submitted By

Kittivut Pipattanachaiyapong | 6638019121
Krin Kaweewongsonthorn | 6638027121
Pakapol Kijsupanont | 6638172421
Phattharamon Sukvivatn | 6638178221

1/2026: 2147498 Capstone Design Project I

Robotics and Artificial Intelligence Engineering (International Program)

International School of Engineering (ISE), Faculty of Engineering,

Chulalongkorn University

## 1 Project Timeline

- Completed: Project concept, objectives, literature review, and phased system architecture established.
- In progress: Phase A — single-module locomotion, sensing, communication, and simulation baseline.
- Next: Phase B — EP-Face docking, task-oriented reconfiguration, and simple assembled locomotion.

## 2 Project Phases

### 2.1 Phase A

External perception and computation. Develop the mechanically homogeneous module, differential-drive locomotion, joint control, odometry, and module-to-commander communication. Validate the module and physics twin before physical docking is introduced.

### 2.2 Phase B

Docking and task-oriented reconfiguration. Add the electropermanent EP-Face connectors, infrared alignment, and connector-state feedback. Extend the reconfiguration pipeline with task assignment, parallel assembly sequencing, and selection from a library of feasible configurations.

### 2.3 Phase C

Onboard perception with external computation. Mount a monocular RGB camera and an 8 × 8 multi-zone ToF sensor on the leader module. Estimate obstacle geometry and traversability locally, while transmitting sensor data to an external computer for processing.

### 2.4 Phase D

Fully onboard perception and computation. Move the perception and configurationselection pipeline onto a coordinator module using an embedded compute board. Close the perceive–select–reconfigure–traverse loop on hardware without external localisation or computation.

## 3 Gantt Chart

Task schedule from the team Notion timeline (as of 25 Sep 2026), grouped by phase.

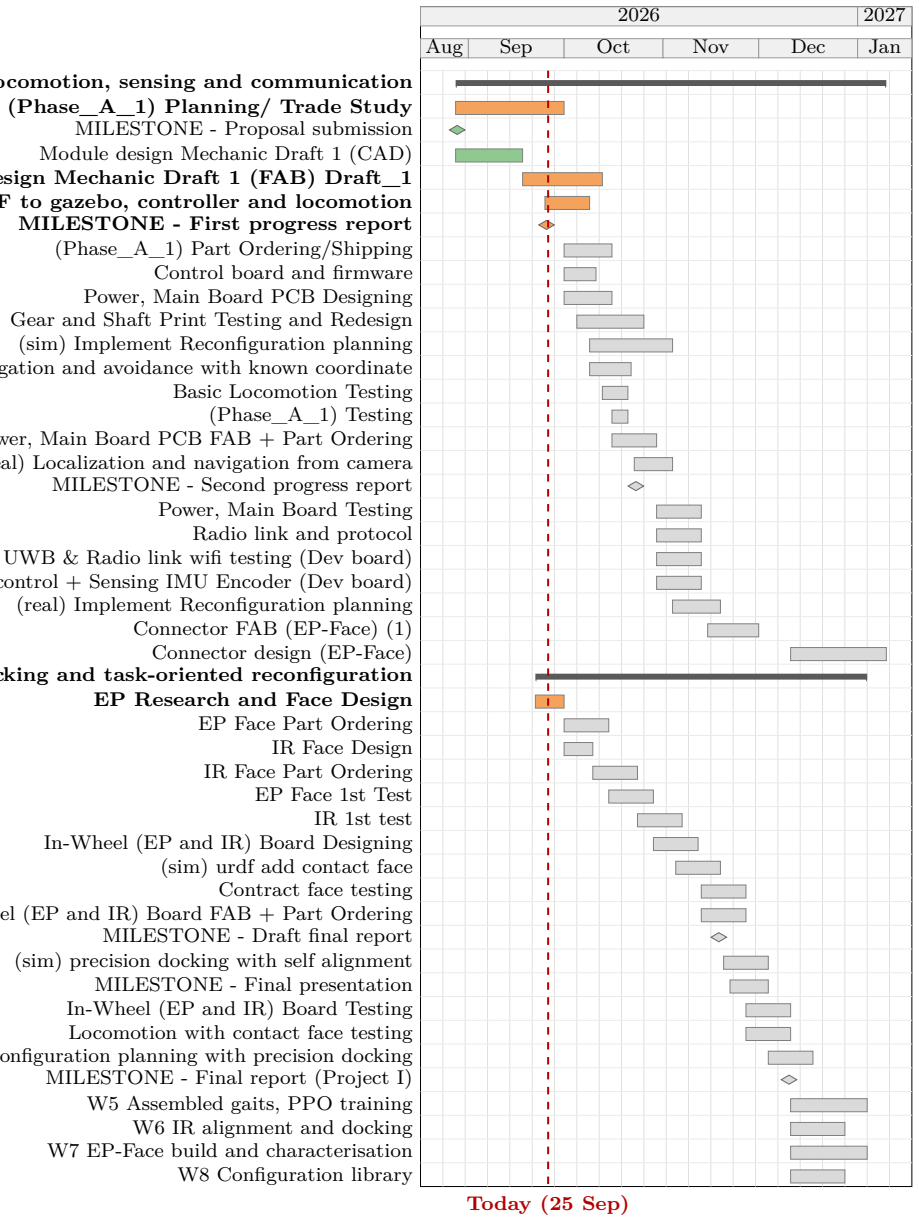
[picture p27: figure]
Aug; Sep; Oct; Nov; Dec; Jan; (Phase_A_1) Planning/ Trade Study MILESTONE - Proposal submission Module design Mechanic Draft 1 (CAD); MILESTONE - First progress report (Phase_A_1) Part Ordering/Shipping Control board and firmware Power, Main Board PCB Designing; (sim) Implement Reconfiguration planning; Basic Locomotion Testing (Phase_A_1) Testing; MILESTONE - Second progress report Power, Main Board Testing Radio link and protocol; (real) Implement Reconfiguration planning Connector FAB (EP-Face) (1) Connector design (EP-Face)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

Phase A — Locomotion, sensing and communication

Module design Mechanic Draft 1 (FAB) Draft_1 (sim) export URDF to gazebo, controller and locomotion

Gear and Shaft Print Testing and Redesign

(sim) Navigation and avoidance with known coordinate

Power, Main Board PCB FAB + Part Ordering (real) Localization and navigation from camera

UWB & Radio link wifi testing (Dev board) low level control + Sensing IMU Encoder (Dev board)

Phase B — Docking and task-oriented reconfiguration

In-Wheel (EP and IR) Board FAB + Part Ordering

(sim) precision docking with self alignment

(real) Reconfiguration planning with precision docking

Figure 1: Project I schedule (Phases A–B). | Completed | In progress | Upcoming;
dashed line marks the report date.

2026 | 2027
Dec | Jan | Feb | Mar | Apr

Phase C — Onboard perception, external computation (sim) Environment classification (sim) onboard perception obstacle avoidance and navigation Onboard perception testing (Real) Onboard Perception nav and configuration planning Inductive Encoder Designing Locomotion, Planning with internal Perception (IR and UWB) W9 Camera and ToF integration W5 Policy training on held-out params W8 Obstacle state to configuration (sim) Configuration lookup table Inductive Encoder FAB + Part Ordering W9 Terrain and traversability pipeline (Real) environment adaptation Inductive Encoder Testing
MILESTONE - Phase C evaluation Phase D — Fully onboard perception and computation PCB for CM5 Designing
PCB for CM5 Designing FAB + Part Ordering W10 Compute module bring-up CM5 with RGBD and TOF Testing Onboard Odometry with no camera testing W4 Onboard odometry, drop VICON (sim) local interaction to reorganize (concept) Full testing internal computation Internal Computation
W10 Quantised inference on module MILESTONE - Loop closed on hardware MILESTONE - Final evaluation (Project II)

Figure 2: Project II schedule (Phases C–D). All tasks upcoming ( ).

## 4 Module CAD Design

The design is based on SMORES-EP [1] (originally 80 mm), scaled to a 100×100×100 mm envelope for additional packaging space.


Figure 3: Exploded view of the module.

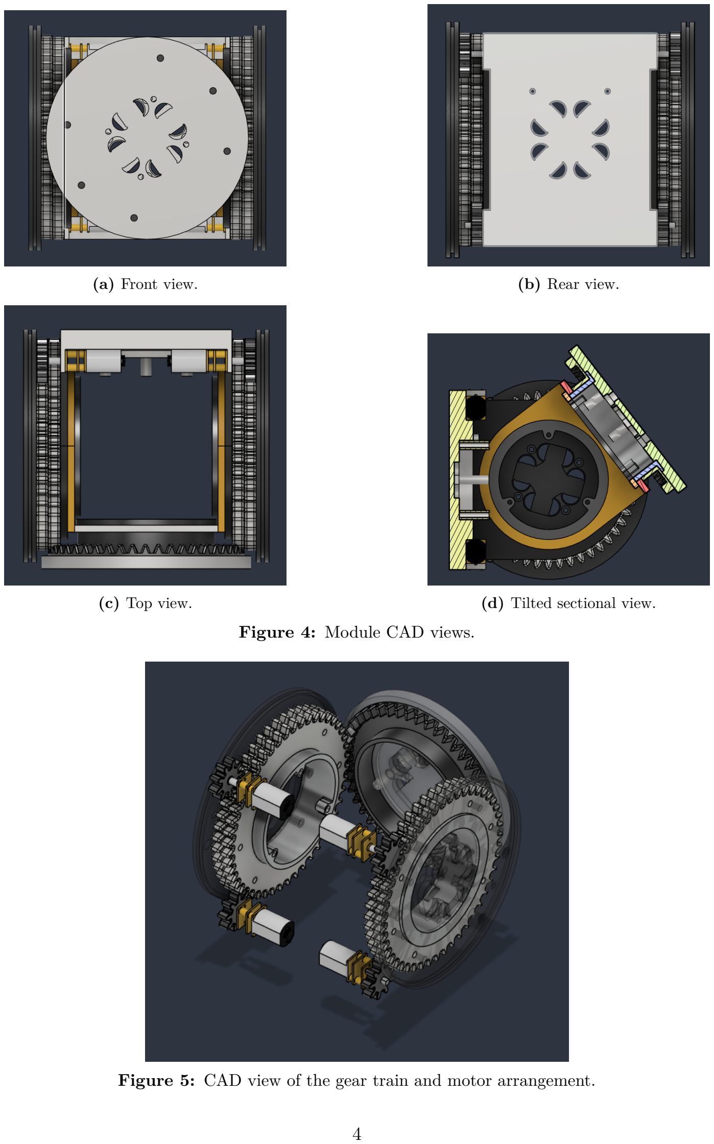
[picture p28: page 5]

(a) Front view. | (b) Rear view.
(c) Top view. | (d) Tilted sectional view.

Figure 4: Module CAD views.

Figure 5: CAD view of the gear train and motor arrangement.

### 4.1 Gear Train Design

### 4.1.1 SMORES-EP Reference Baseline

The original SMORES-EP gear train was reverse-engineered from published data (Table 1), yielding module m = 1.4, pitch diameter 67.2 mm, and stage ratio 48/9 = 5.33.

Table 1: Reconstructed SMORES-EP reference parameters.

Parameter | SMORES-EP

Module envelope 80 × 80 × 80 mm

Spur gear | 48 teeth
Crown gear | Same part as spur, used at 90◦
Pinion | 9 teeth
Gearbox | 298:1

### 4.1.2 New Gear Geometry

The 100 mm envelope allows a max spur gear OD of 90 mm. The 5.33:1 ratio was preserved (64/12 teeth) to keep the gearbox selection, SMORES-EP benchmarks, and control firmware valid. The 64/12 pair was chosen over 48/9 because 12 teeth reduces undercutting, improves contact ratio, and provides a larger pinion bore.

Unlike SMORES-EP (which reuses a spur gear as a crown gear), this design uses a true crown (face) gear for better load distribution. The crown gear was sized to 84 mm OD (46 teeth, m = 1.75) after a 90 mm first attempt interfered with surrounding components.

This creates a module mismatch (m = 1.36 spur vs. m = 1.75 crown) — an accepted compromise since both diameters and tooth counts are fixed by packaging and ratio constraints. The crown dedendum was reduced to 2.15 mm (from standard 2.19 mm) to clear tip interference.

Table 2: Final gear train parameters.

Component | Teeth Module OD | Notes
Wheel spur gear 64 | 1.36 | 90 mm | 5 mm face width, bolt
holes in web
Pinion (both) | 12 | 1.36 | 19.04 mm Through-bore
(pan/tilt) or | blind
(wheel)
Crown gear | 46 | 1.75 | 84 mm | Dedendum 2.15 mm; true face-gear

Common: 20◦ pressure angle, 0.2 mm backlash, 0.3 mm root fillet, 0.1 mm bore tolerance. All gears generated via Fusion 360. Material: 3D-printed nylon.

### 4.1.3 Drivetrain Architecture

Four motors drive four spur gears:

- Outer two — each drives a wheel (differential-drive locomotion).
- Inner two — both mesh with a single crown gear: same direction → pan; opposite directions → tilt.

### 4.1.4 Status

All geometry is CAD-only. No parts have been printed or tested. Priority next steps: print first articles, verify spur/crown mesh despite module mismatch, check 12-tooth pinion undercut at print tolerances, and validate backlash and bore fit.

### 4.2 Outer Wheels

Two independently driven wheels (100 mm diameter) with NBR N70 O-ring tire groove (1.5 mm cross-section), EP-magnet docking space, and PCB mounting posts.

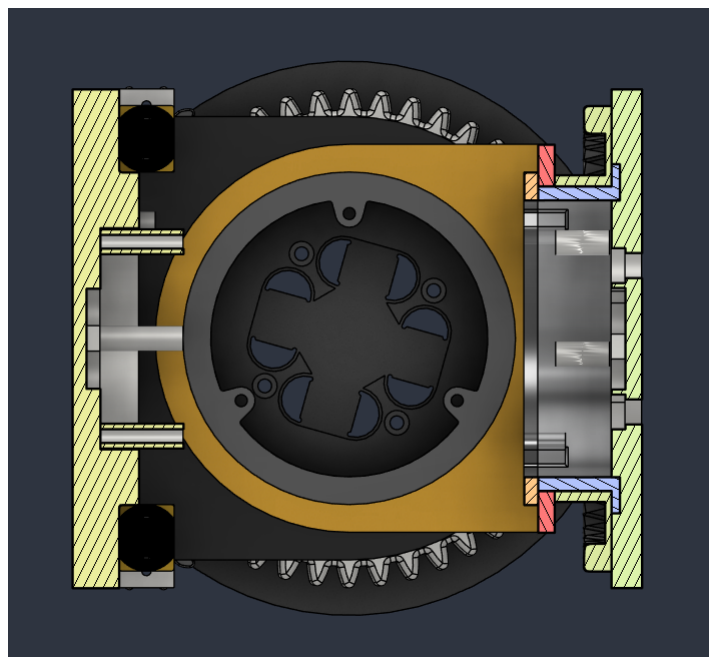
[picture p29: figure]

(a) Interior view (wheel and drivetrain). | (b) Exterior view (wheel and module).

Figure 6: Outer wheel CAD.

### 4.3 Pan Face

90 mm diameter, no O-ring groove. Includes EP-magnet docking space.

### 4.4 Tilt Face

Approximately 90 × 71.6 mm rectangular part with EP-magnet docking space and an additional motor mount.

## 5 Electronics

### 5.1 Phased Electronics Plan

Electronics are built incrementally across project phases:

- Phase A-1: COTS parts — 2S battery, 4-channel motor driver with MCU, ESP32-C3 for Wi-Fi.
- Phase A: Custom PCBs — power board (buck, LDO, 4× H-bridge with current sensing) and main board (STM32G474, IMU, UWB, Wi-Fi).
- Phase B: In-wheel PCB with EP-Face circuitry and IR contact-alignment, connected via slip ring.
- Phase C: RGB-D/ToF camera (Sipeed MaixSense A075V) + wheel encoder added; compute still external.
- Phase D: Raspberry Pi CM5 on custom carrier PCB moves compute onboard.


Figure 7: Phase A-1 electronics block diagram.

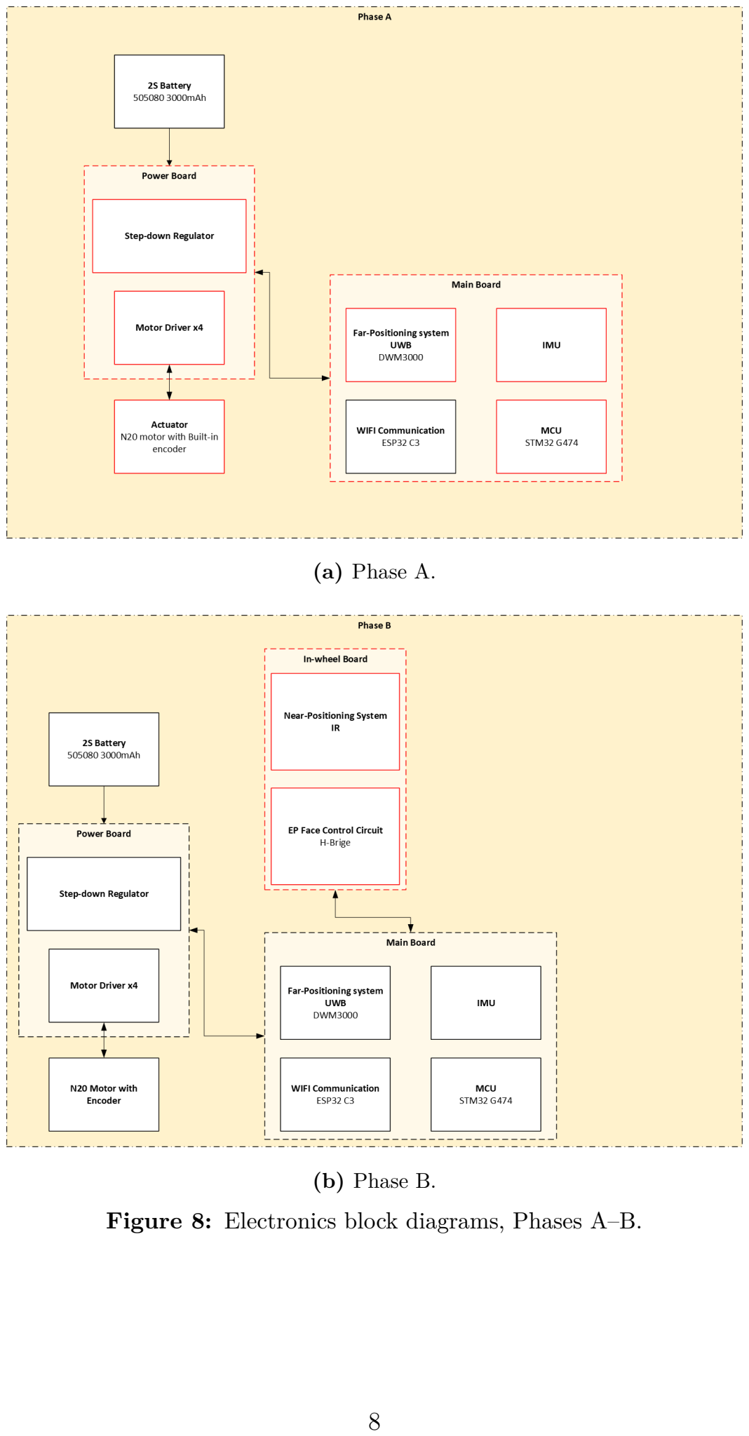
[picture p30: page 9]

(a) Phase A.
(b) Phase B.

Figure 8: Electronics block diagrams, Phases A–B.

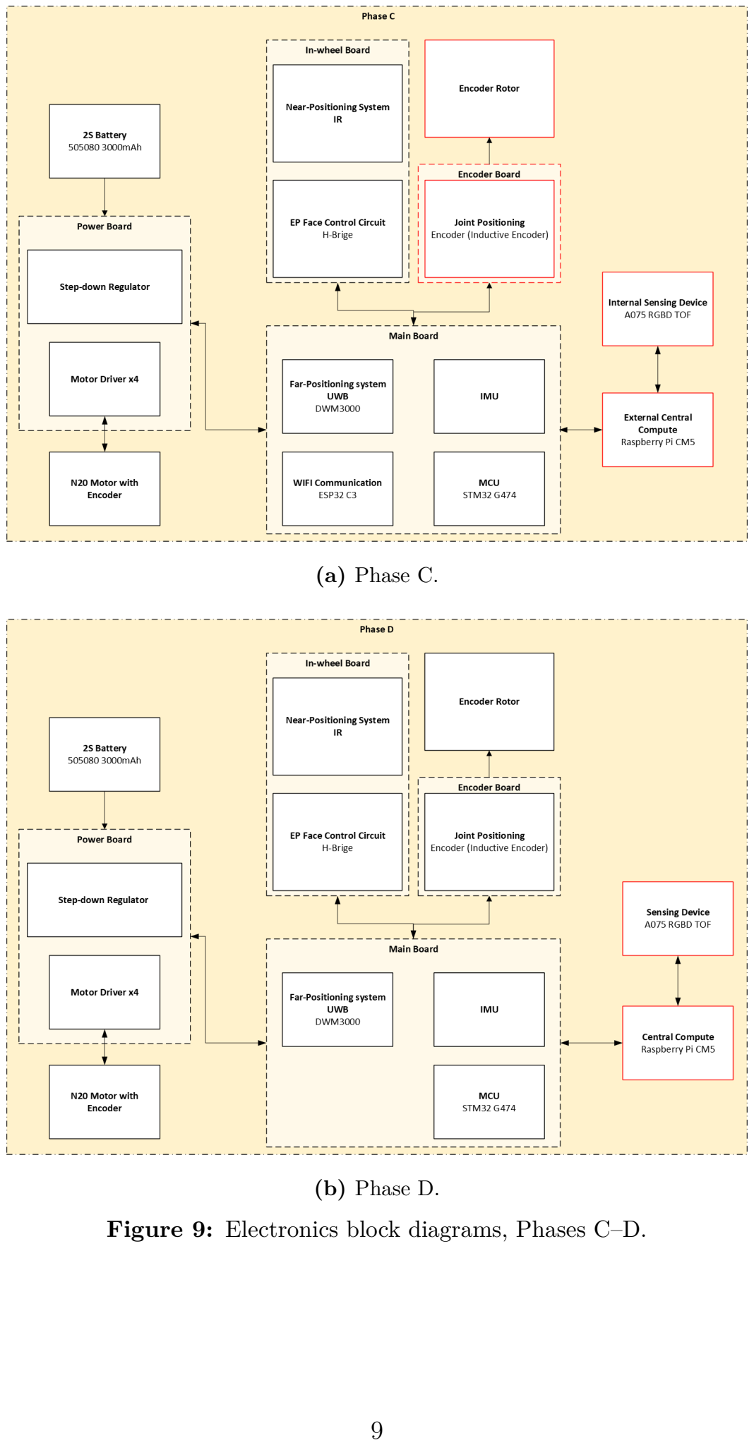
[picture p31: page 10]

(a) Phase C.
(b) Phase D.

Figure 9: Electronics block diagrams, Phases C–D.

### 5.2 Component Selection

Table 3: Key electronics components.

Component | Phase | Key Specs | Interface / Supply
4× N20 gearmotor | A-1+ | 6 V, 50 rpm; 7 PPR encoder | A/B quadrature; H-bridge
STM32G474 | A+ | Cortex-M4F @ 170 MHz; 12-bit ADC; FDCAN | SPI/I2C/UART/CAN; 3.3 V
ICM-42688-P | A+ | ±2000 dps / ±16 g; 32 kHz ODR | SPI or I2C; 1.8 V
DW3000 (UWB) A+ | IEEE 802.15.4z; ∼10 cm ranging | SPI; 3.3 V
ESP32-C3 | A-1+ | Wi-Fi 4 + BLE 5; RISC-V @ 160 MHz | UART/SPI; 3.3 V
EP-Face + IR PCB | B | Custom; EP magnet + IR alignment | Slip ring; 3.3 V
RPi CM5 | D | Cortex-A76 @ 2.4 GHz; up to 16 GB RAM | Custom carrier; 5 V
Sipeed MaixSense A075V | C+ | ToF 320×240 @ 30 fps; RGB 800×600 | USB 2.0; 5 V

### 5.3 Electronics Packaging

All components fit within the 100 mm cube based on rough CAD placement (Figure 10).

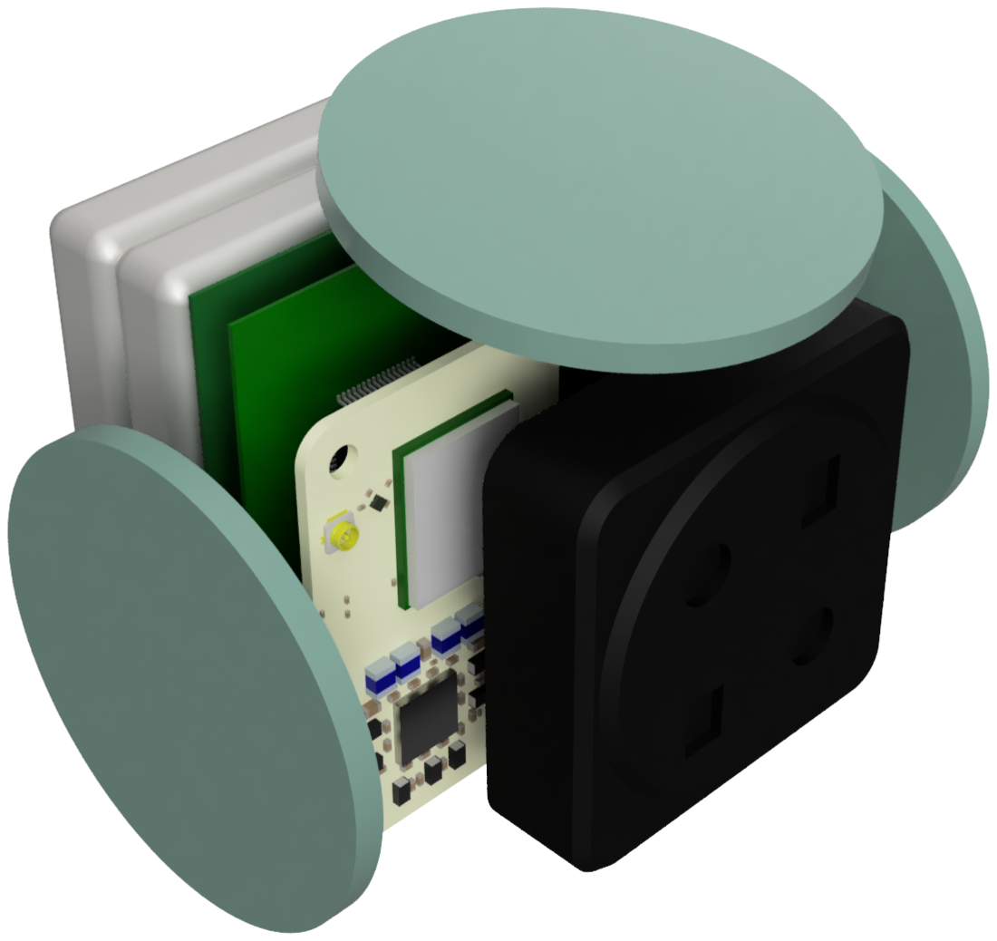
[picture p32: figure]

(a) Assembled. | (b) Exploded.

Figure 10: Electronics packaging.

### 5.4 Wheel Encoder

Replacing the original continuous-rotation potentiometer (∼5

| ◦
resolution, contact wear)
with a non-contact encoder. Three options considered:

Table 4: Wheel encoder options.

On-axis magnetic
(AS5600)
Off-axis tape | Custom inductive
Output | Absolute, 12–14 bit | Incremental + index | Absolute
EP interference | Sensitive | Sensitive | Immune
Design effort | Low | Medium | High

The inductive option best handles the EP connector’s nearby field but has the highest schedule risk. Decision deferred to Phase C.

### 5.5 Power System


Figure 11: Power distribution block diagram.

Power from a 2S LiPo (3000 mAh, 22.2Wh) splits three ways:

- Motors: 4× N20 via H-bridges, PWM capped at ∼70 % for 6 V rating.
- EP-Face: Dedicated buck regulator isolates pulse transients from logic rail.
- Logic/compute: Buck to 5 V (CM5, camera); LDO to 3.3 V (MCU, sensors, radios).

Table 5: Power budget summary.

Configuration | Total from Pack | Est. Run Time
Phase A–B (no compute/camera) | ∼3.1W | ∼5.8 h
Phase D (full system) | ∼11.5W | ∼1.5 h

Table 6: Maximum load per rail.

Rail | Max Current | Max Power
Motor drive (PWM to 6 V) | 4.0 A (6 V eq.) | 24W
5 V logic/compute | 4.0 A | 20W
3.3 V (from 5 V LDO) | 0.45 A | 1.5W
EP-Face + IR | TBD | TBD
Pack total (peak) | ∼6.5 A @ 7.4 V | ∼47W

## 6 Shaft Tolerance Analysis (∅55 mm Bearing)

The plain bearing (OD = 55 mm) acts as the shaft. All nylon-printed components have bores around it.


Figure 12: Shaft and bearing component arrangement.

Table 7: Joint classification and ISO fits for ∅55 mm bearing.

Joint Component | Motion | Fit | ISO Class
J1 | Wheel + 1st Spur Gear | Dynamic Clearance | F7/h6
J2 | 2nd Spur Gear (Pan/Tilt) Dynamic Clearance | F7/h6
J3 | Upper Tilt Joint | Dynamic Clearance | F7/h6
J4 | Lower Tilt Joint | Static | Interference P7/h6

ISO 286 limits (bearing h6: 55.000–54.981 mm): Dynamic F7 bore 55.030–55.060 mm (clearance +0.030 to +0.079 mm); Static P7 bore 54.938–54.968 mm (interference +0.013 to +0.062 mm).

FDM nylon compensation: Printed holes shrink ∼0.10–0.30 mm. Dynamic bores get +0.20 mm compensation; static bores get +0.10 mm (shrinkage helps create interference).

Table 8: Recommended CAD bore sizes.

Part | Joint | CAD Bore (mm) Expected Fit
Wheel / Spur Gears / Upper Tilt J1–J3 Dynamic | ∅55.30 | ≈ 0.10–0.20 CL
Lower Tilt Joint | J4 Static | ∅54.90 | ≈ 0.05–0.15 IF
CL = Clearance | IF = Interference | Bearing OD = ∅55.00 mm

Test plan: Print nylon test rings at five bore sizes per fit type (dynamic: 55.10–55.50 mm; static: 54.90–55.30 mm). Cool ≥2 h, measure with caliper at 3 angles. Pick smallest dynamic bore that spins freely; largest static bore that prevents rotation.

## 7 Software Testing Plan (Phase A)

### 7.1 Objectives

Verify the integrated software pipeline: AprilTag detection and robot ID via external camera → real-time pose estimation → PID motor control → path planning and execution for MSRR configurations.

### 7.2 Setup

MSRR robot in a controlled indoor environment with an external camera, AprilTags for ID and pose reference, and a computing system running perception, localisation, planning, and control.

### 7.3 Goal Configurations

Snake, Car, DoubleDriver, L-shape.

### 7.4 Evaluation Metrics

- Detection rate — % frames with correct AprilTag ID.
- Position / orientation error — estimated vs. reference pose.
- Tracking error — desired vs. actual position and heading during path following.
- Control response — PID overshoot and steady-state error.
- Processing rate — perception + control update frequency.

### 7.5 Acceptance Criteria

Reliable tag detection, acceptable localisation and tracking error for real-time control, stable PID behaviour without excessive oscillation, and continuous operation without critical failures. Specific numerical thresholds to be defined based on system requirements.

## 8 Preparation for Phase B: EP Magnet

The docking system uses an Electro-Permanent Magnet (EPM) connector based on SMORES-EP [1]. Each EP unit pairs an AlNiCo 5 magnet (low coercivity, switchable) with an NdFeB magnet (high coercivity, fixed) between steel pole pieces, wound with a copper coil.


Figure 13: Interior view of the rectangular magnet housing.

Operating principle: A current pulse through the coil reverses AlNiCo 5 magnetisation while NdFeB stays fixed. Fields aligned → ON (attract); fields opposed → OFF (release). No power needed to hold either state.

Materials: AlNiCo 5 rod, NdFeB magnet, mild steel 1018/S20C pole pieces, 30 AWG enamelled copper wire (200 turns). Original dimensions (4.76 mm dia. × 9.53 mm, four magnets in 42 mm ring) being adapted for the 100 mm face. Final dimensions and driving circuit to be set in Phase B testing.

## Additional References

[1] Tosun, T., Davey, J., Liu, C., & Yim, M. (2016). Design and characterization of the EP-Face connector. In IEEE/RSJ International Conference on Intelligent Robots and Systems (IROS) (pp. 45–51).
