JaiPipatt/Capstone-Project/progress_reports/image/ep_magnet_diagram.png

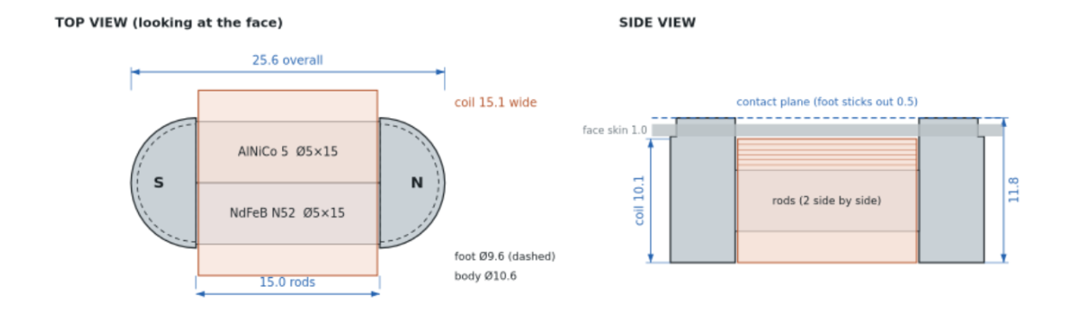
progress_reports/image/ep_magnet_diagram.png
