JaiPipatt/Capstone-Project/progress_reports/image/Phase_A1_CAD.png

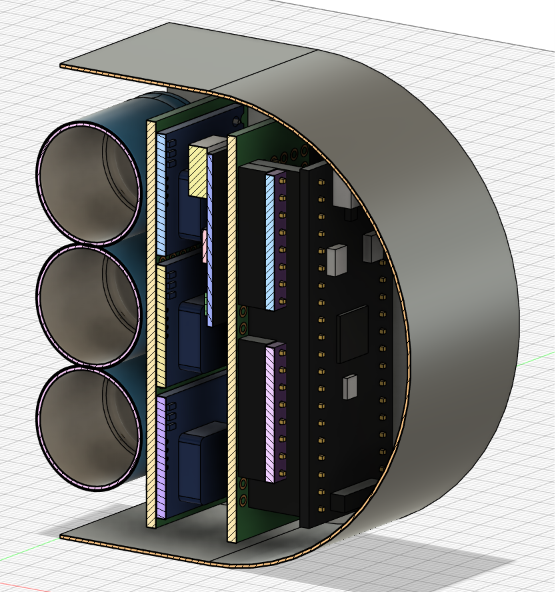
progress_reports/image/Phase_A1_CAD.png
