JaiPipatt/Capstone-Project/ros2_ws/src/my_robot_description/meshes/pan_face_collision.stl

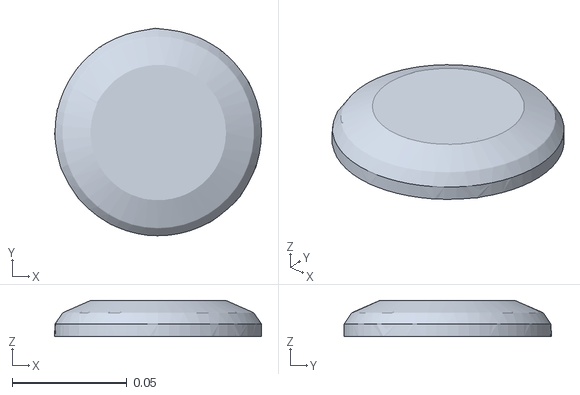
[picture p35: CAD file, 2026-10-03]
ros2_ws/src/my_robot_description/meshes/pan_face_collision.stl
0.0902 x 0.0904 x 0.0158
