JaiPipatt/Capstone-Project/ros2_ws/src/my_robot_description/meshes/base_link_collision.stl

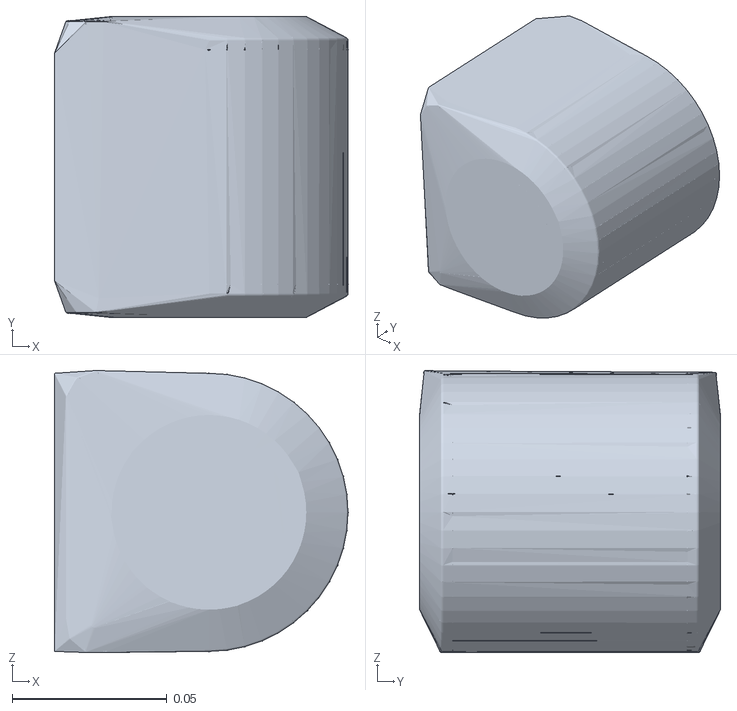
[picture p36: CAD file, 2026-10-03]
ros2_ws/src/my_robot_description/meshes/base_link_collision.stl
0.0952 x 0.0974 x 0.0913
