JaiPipatt/Capstone-Project/ros2_ws/src/my_robot_description/meshes/left_wheel_collision.stl

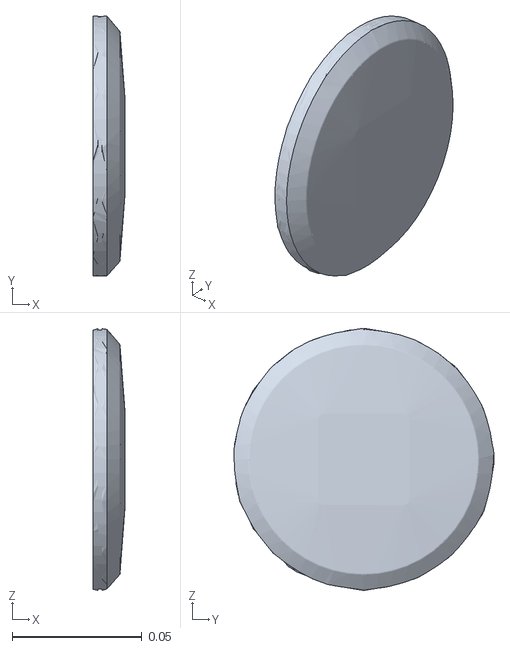
[picture p37: CAD file, 2026-10-03]
ros2_ws/src/my_robot_description/meshes/left_wheel_collision.stl
0.0125 x 0.1 x 0.101
