JaiPipatt/Capstone-Project/ros2_ws/src/my_robot_description/meshes/tilt_body_collision.stl

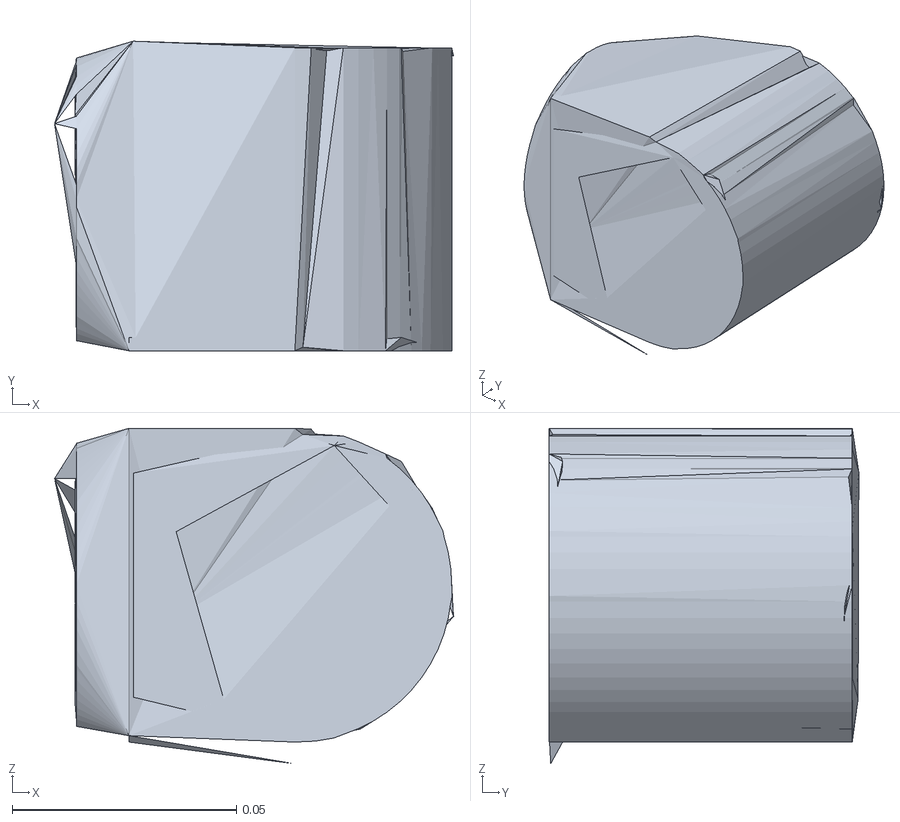
[picture p38: CAD file, 2026-10-03]
ros2_ws/src/my_robot_description/meshes/tilt_body_collision.stl
0.089 x 0.0691 x 0.0748
