JaiPipatt/Capstone-Project/ros2_ws/src/my_robot_description/meshes/pan_face_visual.obj

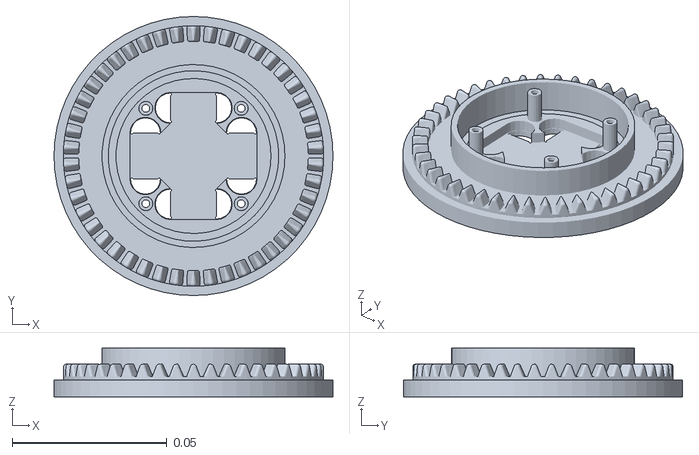
[picture p39: CAD file, 2026-10-03]
ros2_ws/src/my_robot_description/meshes/pan_face_visual.obj
0.09 x 0.09 x 0.0158
