JaiPipatt/Capstone-Project/ros2_ws/src/my_robot_description/meshes/left_wheel_visual.obj

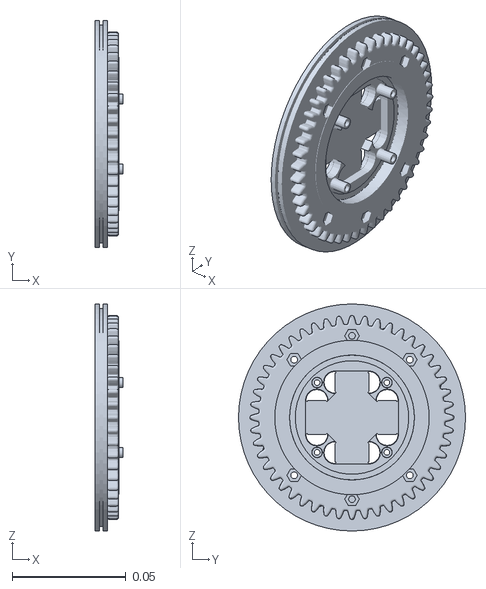
[picture p40: CAD file, 2026-10-03]
ros2_ws/src/my_robot_description/meshes/left_wheel_visual.obj
0.0125 x 0.1 x 0.1
