JaiPipatt/Capstone-Project/ros2_ws/src/my_robot_description/meshes/tilt_body_visual.obj

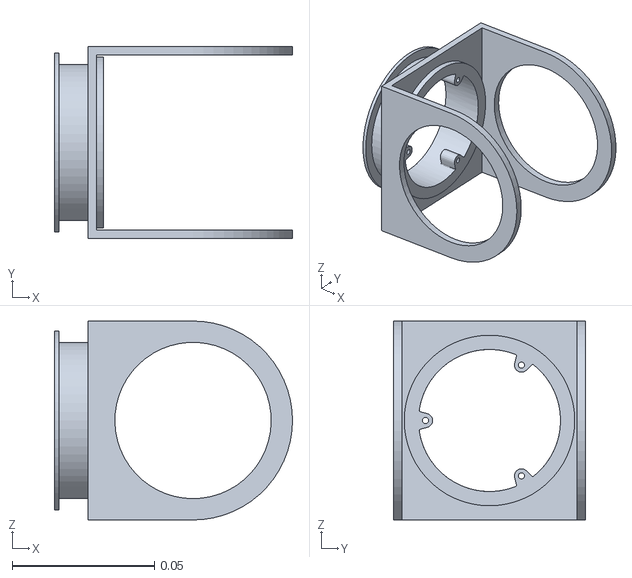
[picture p41: CAD file, 2026-10-03]
ros2_ws/src/my_robot_description/meshes/tilt_body_visual.obj
0.0838 x 0.0676 x 0.07
