JaiPipatt/Capstone-Project/ros2_ws/src/my_robot_description/meshes/base_link_visual.obj

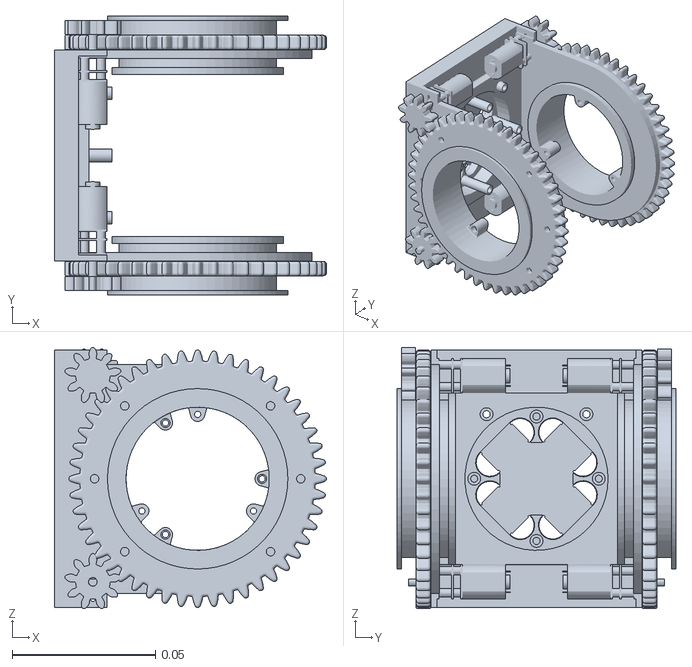
[picture p42: CAD file, 2026-10-03]
ros2_ws/src/my_robot_description/meshes/base_link_visual.obj
0.095 x 0.0974 x 0.0913
