JaiPipatt/Capstone-Project/(list of files, cad)

Other CAD files:
ros2_ws/src/my_robot_description/meshes/right_wheel_collision.stl
ros2_ws/src/my_robot_description/meshes/right_wheel_visual.obj
