JaiPipatt/Capstone-Project/progress_reports/image/assembled_motor_mount.jpg

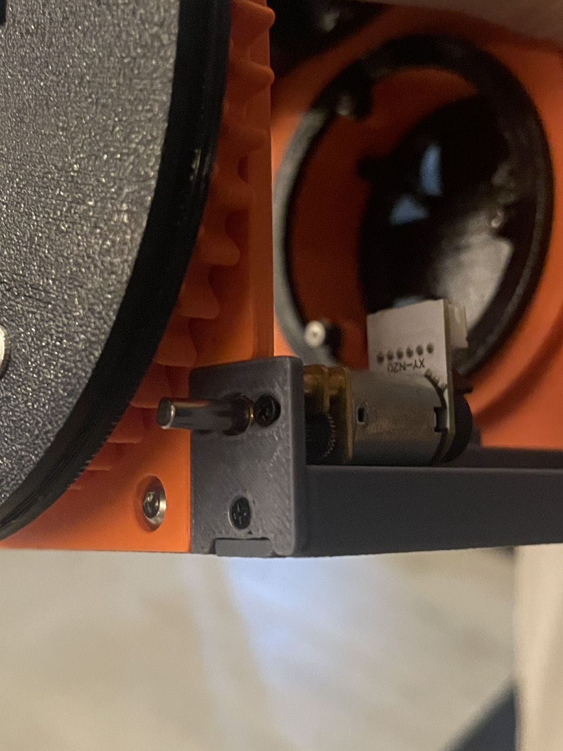
progress_reports/image/assembled_motor_mount.jpg
