JaiPipatt/Capstone-Project/progress_reports/image/assembled_top_view.jpg

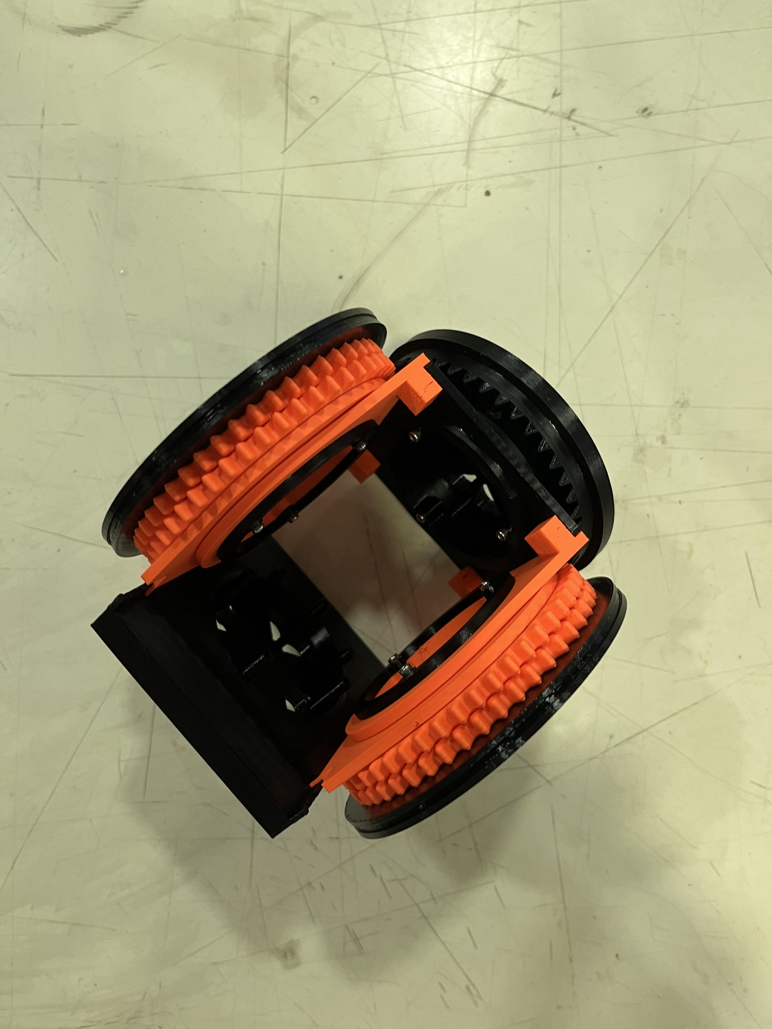
progress_reports/image/assembled_top_view.jpg
