JaiPipatt/Capstone-Project/(commit log)

2026-09-17 Gear design part
2026-09-17 fix: restore lost Software Testing Plan for Phase A section
    Merging progress_report_1 into prepraestellar (dab9417) resolved a
    conflict by taking prepraestellar's side of progress_report.tex,
    dropping the whole "Software Testing Plan for Phase A" section added
    in 9da10c1/f02d709. Restored the section text from that commit into
    the current file, filling the "Perception Testing Plan" stub that
    same commit had renamed.
2026-09-21 Add shaft component image and update progress report with CAD design details
2026-10-03 Add MSRR ROS 2 robot description
    [assemply.urdf, base_link_visual.obj, left_wheel_visual.obj, pan_face_visual.obj, right_wheel_visual.obj, tilt_body_visual.obj]
2026-10-03 feat: add collision and ros2_control, disable self-collision
    [assemply.urdf, base_link_collision.stl, left_wheel_collision.stl, pan_face_collision.stl, right_wheel_collision.stl, tilt_body_collision.stl]
2026-10-16 fix: clean up URDF TF frames (align link frames with base_link)
2026-10-16 refactor: convert URDF to xacro
2026-10-16 docs: document actuator layout and pan/tilt differential gearing
2026-10-16 feat: add link colors and close-up Gazebo camera
2026-10-16 feat: multi-module simulation with namespaces and ground-truth pose
2026-10-19 docs(progress_reports): add teleop architecture and PETG shaft fit to report 2
    - add teleoperation architecture TikZ figure (shared ROS 2 layer, sim vs real)
    - replace shaft bore recommendations with tested +0.15 mm offset on all bores
    - switch printed material from nylon to PETG
2026-10-20 progress report 2: electronics sections 5.5-5.8 (Nat)
    - 5.5 Changes from PR1: one-week delay, Phase A-1 build (STM32F411 +
    2x TB6612FNG + ESP32-C6), battery 2S 505080 -> 3S Vapcell M11 18350
    - 5.6 Phase A-1 hardware: schematic, packaging CAD, power budget,
    CubeMX setup and peripheral table
    - 5.7 New power calculation replacing PR1 power system section
    - 5.8 Next steps toward Phase A main and power PCBs
    - Add Phase A-1 schematic, CAD and CubeMX images; rebuild PDF
    Claude-Session: https://claude.ai/code/session_01BHKxBRe9ZncuqkwL6FxpF6
2026-10-21 docs(report2): add assembled prototype photos section
2026-10-21 fix(report2): remove duplicate assembled prototype section
2026-10-26 feat(communcation): add esp32Bridge node forwarding cmd_vel to ESP32 over UDP
2026-10-29 refactor(communcation): replace UDP esp32Bridge with micro-ROS agent
    ESP32 modules now run micro-ROS and subscribe to
    /module_i/diff_drive_controller/cmd_vel_unstamped directly through the
    micro-ROS agent, so the custom UDP bridge node is removed. Add README
    with agent run commands (snap/docker) and the ESP32-side topic contract.
2026-11-02 fix(sim): spawn module controllers sequentially
    All controller_managers run inside the single Gazebo process, and
    pluginlib's class loader is not thread-safe: spawning controllers for
    several modules at once made all but one fail with "no factory exists"
    for diff_drive_controller. Chain the spawners so module i starts after
    module i-1's spawner exits, and raise the controller-manager timeout.
2026-11-02 docs(communcation): add hotspot setup and agent IP for ESP32 link
